mjohansson/customlib_mj/README.md

# customlib_mj
Kicad custom parts library by MJ
