mjohansson/customlib_mj/3d_models/DS3231_Module_MJ-assembly.stp

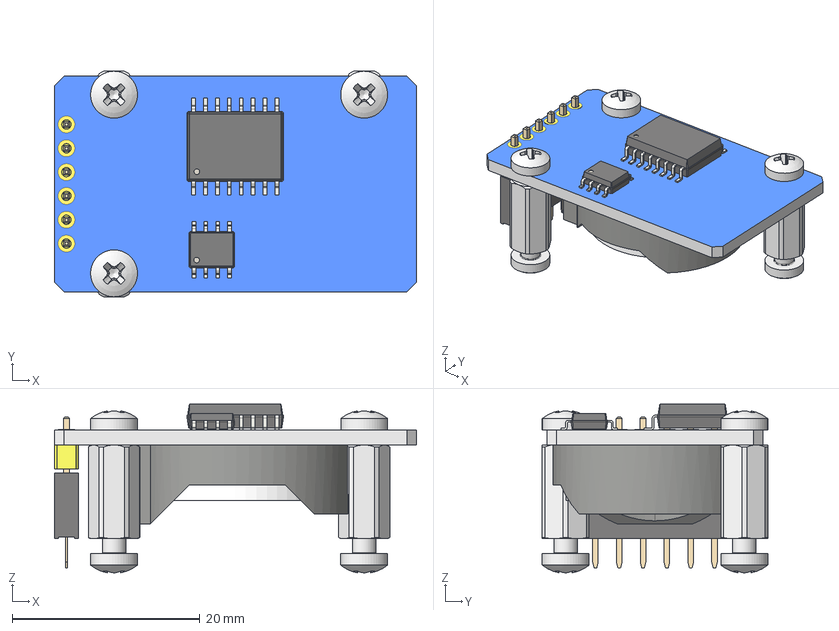
[picture p1: CAD file, 2021-01-10]
3d_models/DS3231_Module_MJ-assembly.stp
38.6 x 24.1 x 18.0 mm
DS3231_module_with_backup_battery
PinHeader_1x06_P254mm_Vertical
Battery_Holder
DS3231SN_SOIC_16W
24C32N_SOIC_8
M2.5x5x10-Spacer
M2.5x5x10-Spacer001
M2.5x5x10-Spacer002
M2.5x6-Screw
M2.5x6-Screw008
M2.5x6-Screw002
M2.5x6-Screw003
M2.5x6-Screw006
M2.5x6-Screw007
PinSocket_1x06_P254mm_Vertical
