mjohansson/customlib_mj/3d_models/SMA_bulkhead_jack_and_cable_assy.stp

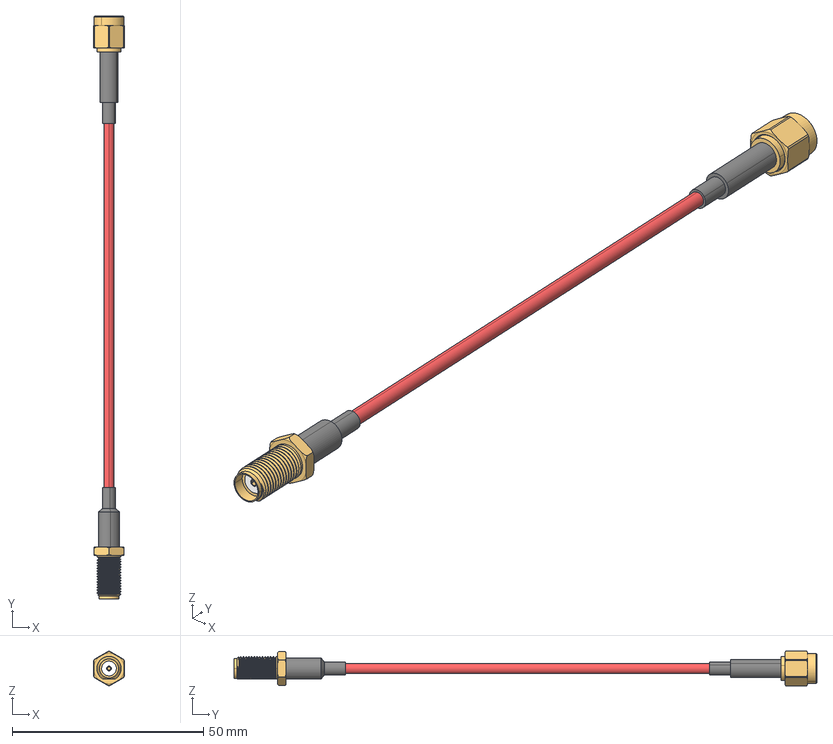
[picture p2: CAD file, 2021-01-10]
3d_models/SMA_bulkhead_jack_and_cable_assy.stp
8.00 x 152.4 x 9.04 mm
