mjohansson/customlib_mj/3d_models/3dholder_left_asm.stp

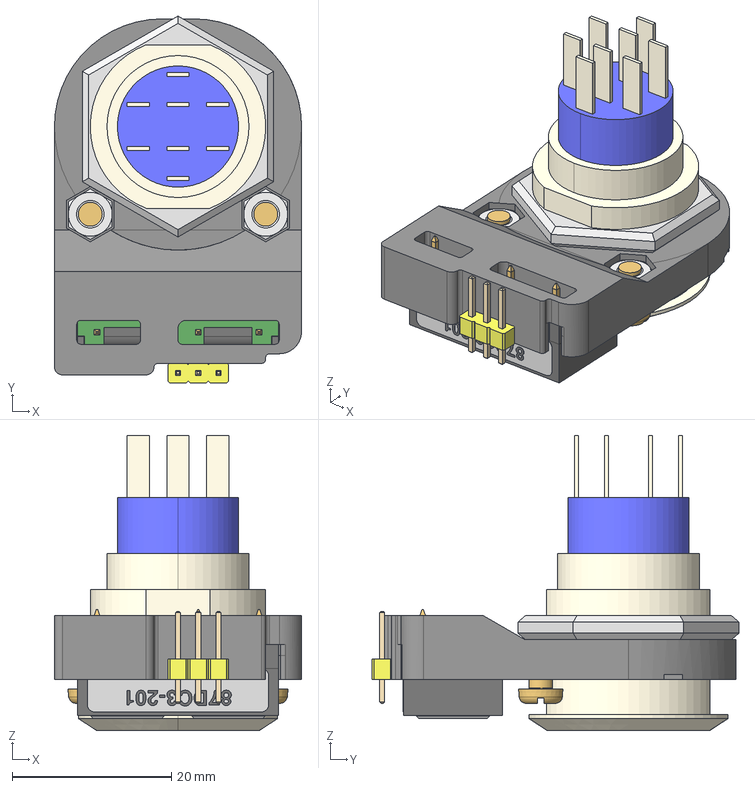
[picture p3: CAD file, 2021-01-10]
3d_models/3dholder_left_asm.stp
31.0 x 46.0 x 37.0 mm
PinHeader_1x03_P254mm_Vertical
RSpro_PowerButton_Blue
M3x6-Screw001
M3x6-Screw
3d_holder_left_v004
HexNut_M19_thin
M3-Nut
M3-Nut001
Compound_Grayhill_87DC3-201
