mjohansson/customlib_mj/3d_models/3dholder_right_asm.stp

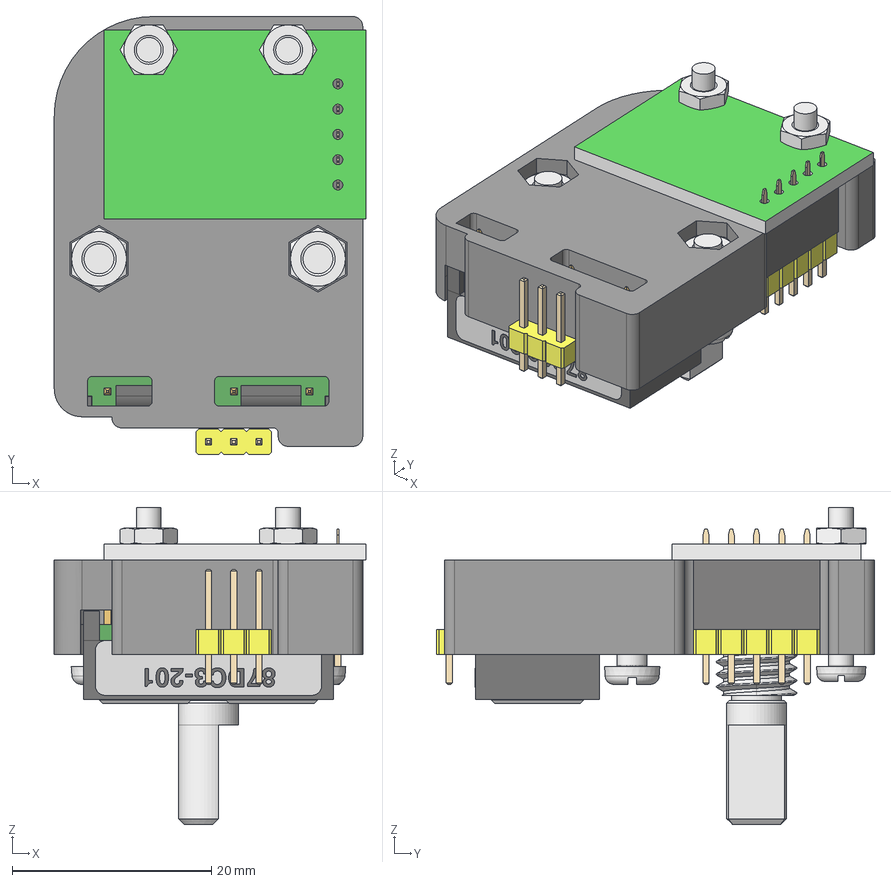
[picture p4: CAD file, 2021-01-10]
3d_models/3dholder_right_asm.stp
31.3 x 44.0 x 31.9 mm
PinSocket_1x05_P254mm_Vertical
PinHeader_1x05_P254mm_Vertical
PinHeader_1x03_P254mm_Vertical
3d_holder_right-r3
M2.5-Nut001
M2.5-Nut
M2.5x16-Screw001
M2.5x16-Screw
M3-Nut001
M3-Nut
M3x10-Screw001
M3x10-Screw
Compound_Grayhill_87DC3-201
Boolean
