mjohansson/customlib_mj/3d_models/Molex_PicoBlade_4p_Cable_assy-151340402.stp

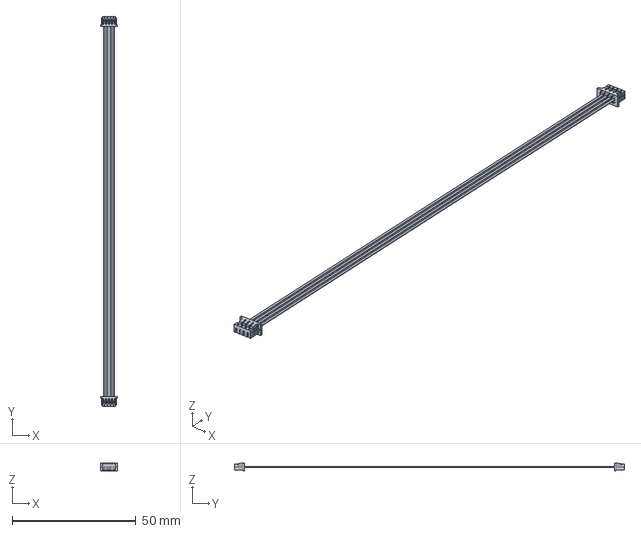
[picture p5: CAD file, 2020-11-03]
3d_models/Molex_PicoBlade_4p_Cable_assy-151340402.stp
6.75 x 157.9 x 3.20 mm
