mjohansson/customlib_mj/3d_models/Molex_PicoBlade_4p_Cable_assy-151340403.stp

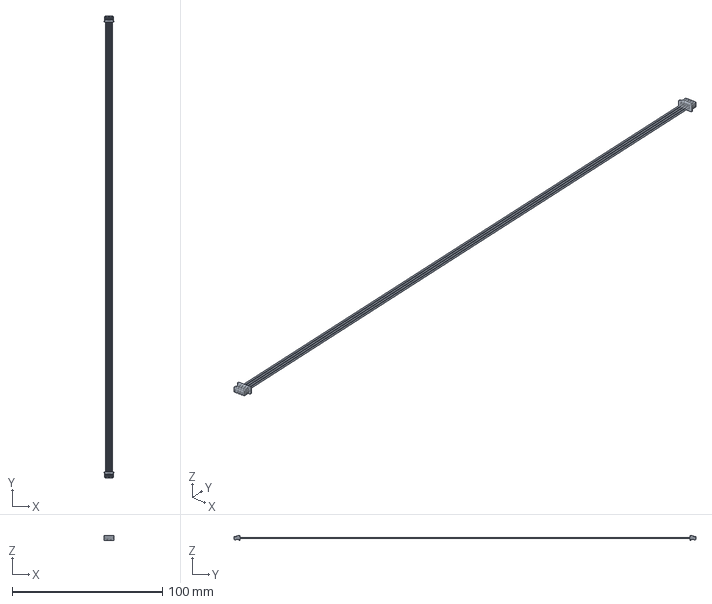
[picture p6: CAD file, 2020-11-03]
3d_models/Molex_PicoBlade_4p_Cable_assy-151340403.stp
6.75 x 307.9 x 3.20 mm
