mjohansson/customlib_mj/3d_models/CUI_DEVICES_CES-703116-28PM_fasteners_assembly.step

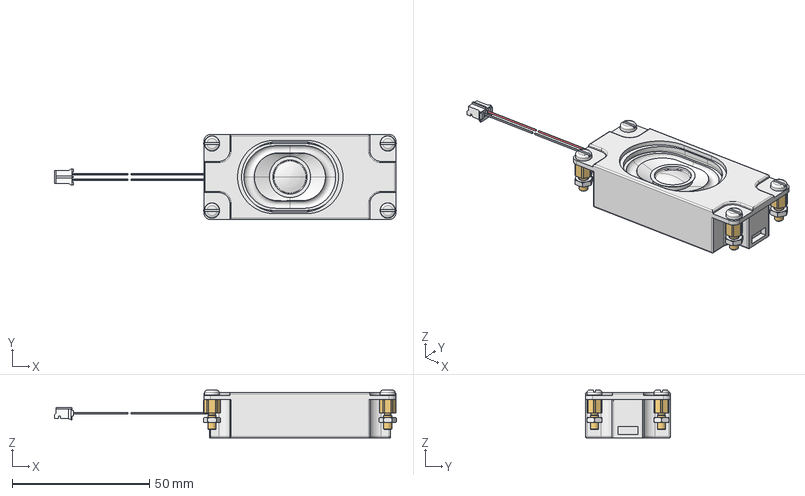
[picture p7: CAD file, 2020-09-05]
3d_models/CUI_DEVICES_CES-703116-28PM_fasteners_assembly.step
124.5 x 31.0 x 17.4 mm
CUI_DEVICES_CES-703116-28PM
M3x5.5x5-Standoff
M3x5.5x5-Standoff001
M3x5.5x5-Standoff002
M3x5.5x5-Standoff003
M3-Nut006 x 4
M3x5-Screw005 x 4
