mjohansson/customlib_mj/3d_models/Jing-Extension-of-the-Electronic-Co--920-E52A2021S10100_C10418.stp

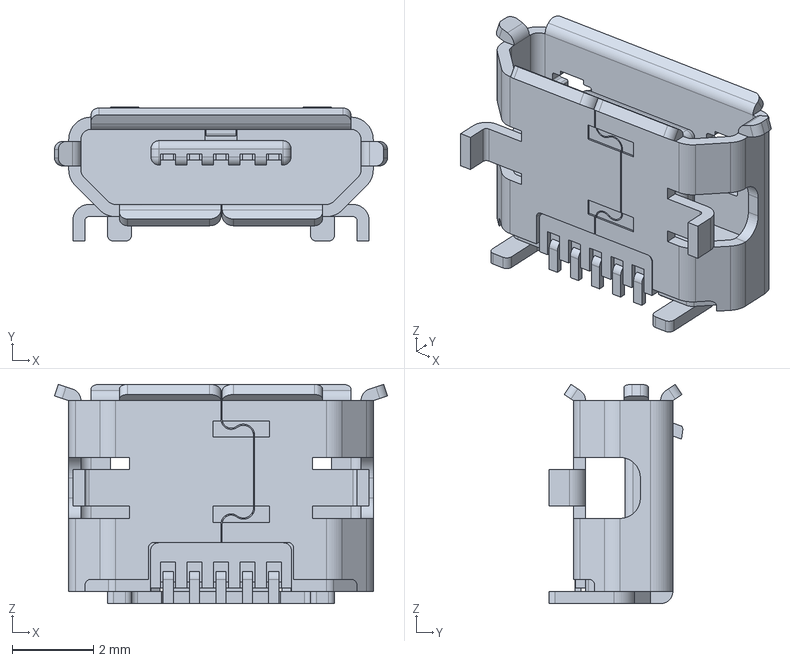
[picture p8: CAD file, 2024-02-26]
3d_models/Jing-Extension-of-the-Electronic-Co--920-E52A2021S10100_C10418.stp
8.20 x 3.30 x 5.40 mm
