mjohansson/customlib_mj/3d_models/3d_assm_bottomplate_w_feet.step

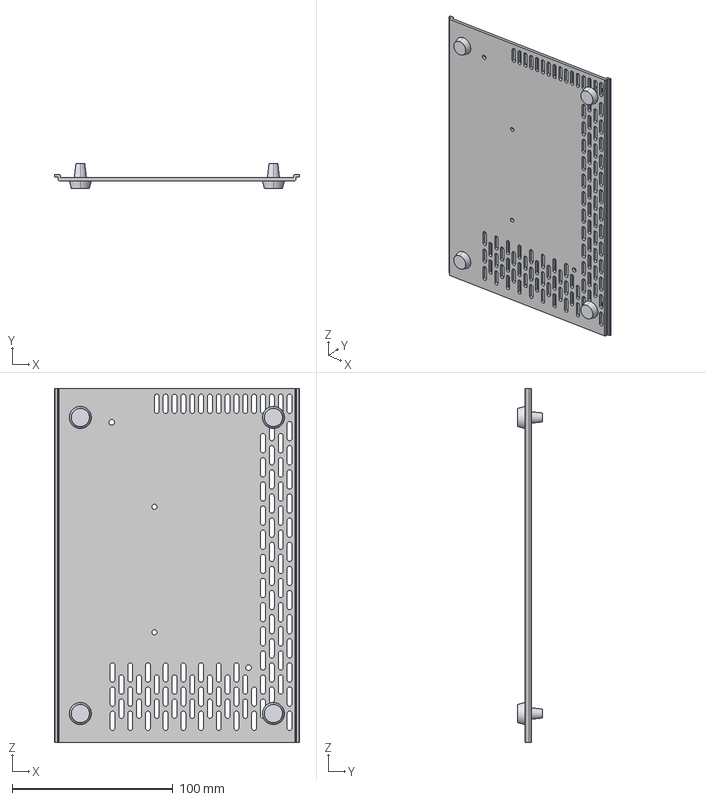
[picture p10: CAD file, 2022-02-02]
3d_models/3d_assm_bottomplate_w_feet.step
152.4 x 15.6 x 220.0 mm
Bottom_Cap_w_back_vent_slots001
POF-50185_push-on_feet-FL
POF-50185_push-on_feet-FR
POF-50185_push-on_feet-RR
POF-50185_push-on_feet-RL
