mjohansson/customlib_mj/3d_models/Distance9mm-Hex5mm_plus_M3x6.step

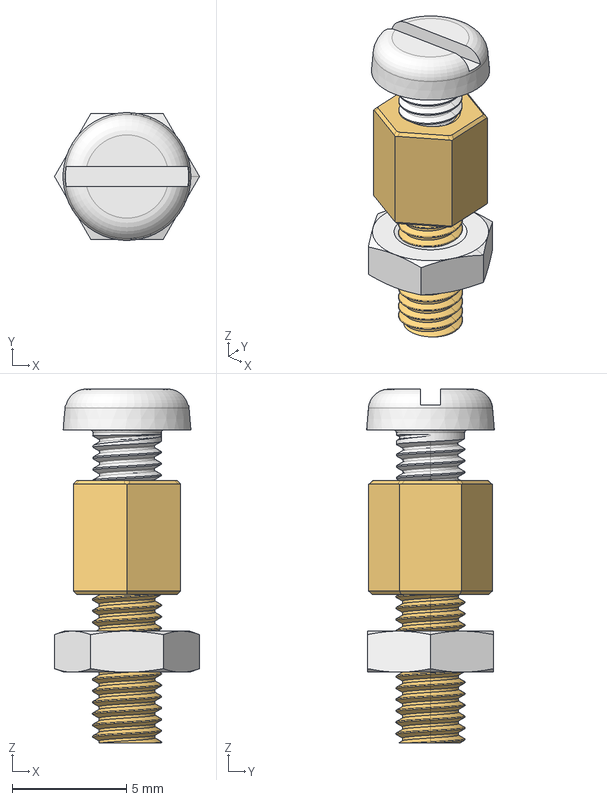
[picture p11: CAD file, 2021-01-10]
3d_models/Distance9mm-Hex5mm_plus_M3x6.step
6.35 x 5.60 x 15.5 mm
ISO1580-M3x6_screw
Hexdistance5mm_M3x6
ISO4035-M3_thin_nut
