mjohansson/customlib_mj/3d_models/FFC_14p_50mm_folded_x2.stp

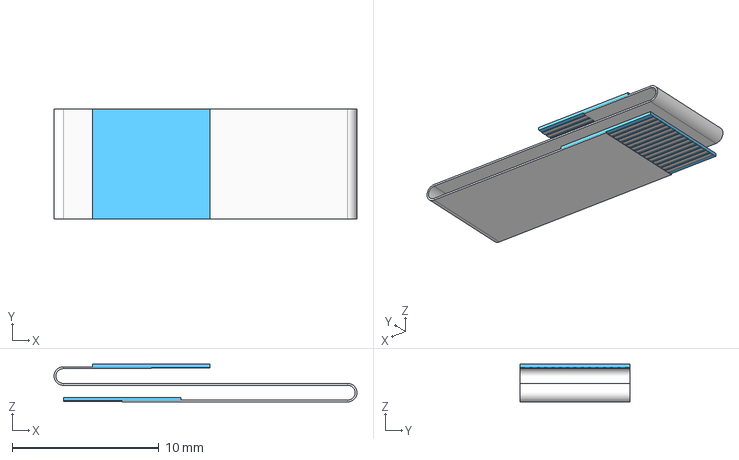
[picture p12: CAD file, 2021-01-10]
3d_models/FFC_14p_50mm_folded_x2.stp
20.6 x 7.50 x 2.57 mm
