mjohansson/customlib_mj/3d_models/SC74-6_SOT-457.stp

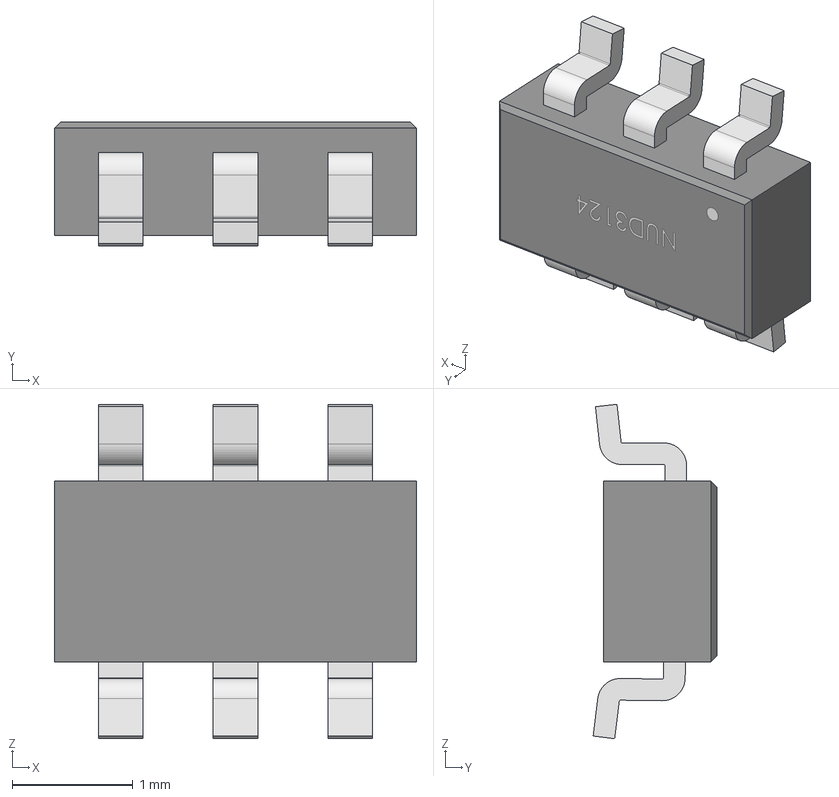
[picture p13: CAD file, 2021-01-10]
3d_models/SC74-6_SOT-457.stp
3.00 x 1.03 x 2.77 mm
