mjohansson/customlib_mj/3d_models/DistanceHex10mm_M3.step

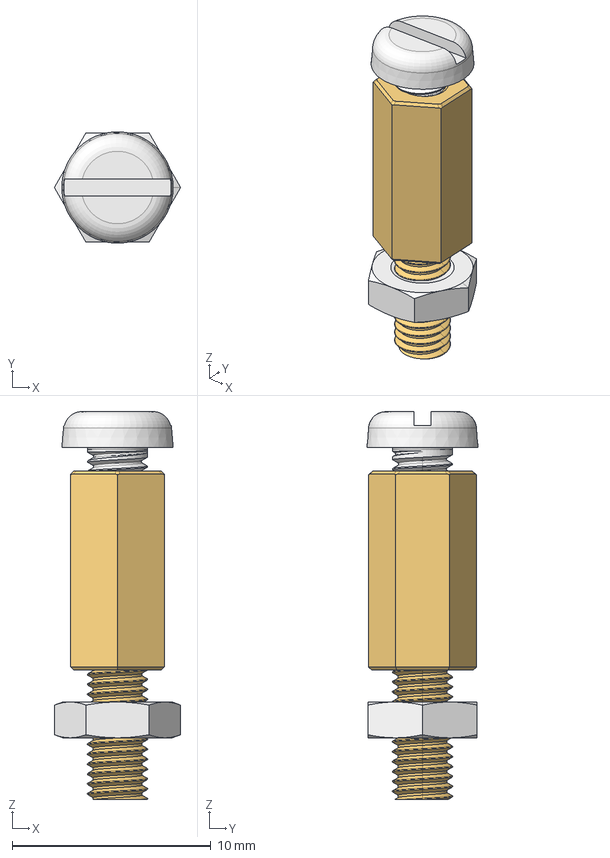
[picture p14: CAD file, 2021-01-10]
3d_models/DistanceHex10mm_M3.step
6.35 x 5.60 x 19.5 mm
Hexdistance10mm_M3
ISO4035-M3_NUT
ISO1580-M3x6_SCREW
