mjohansson/customlib_mj/3d_models/MJ_KY040_rotary.stp

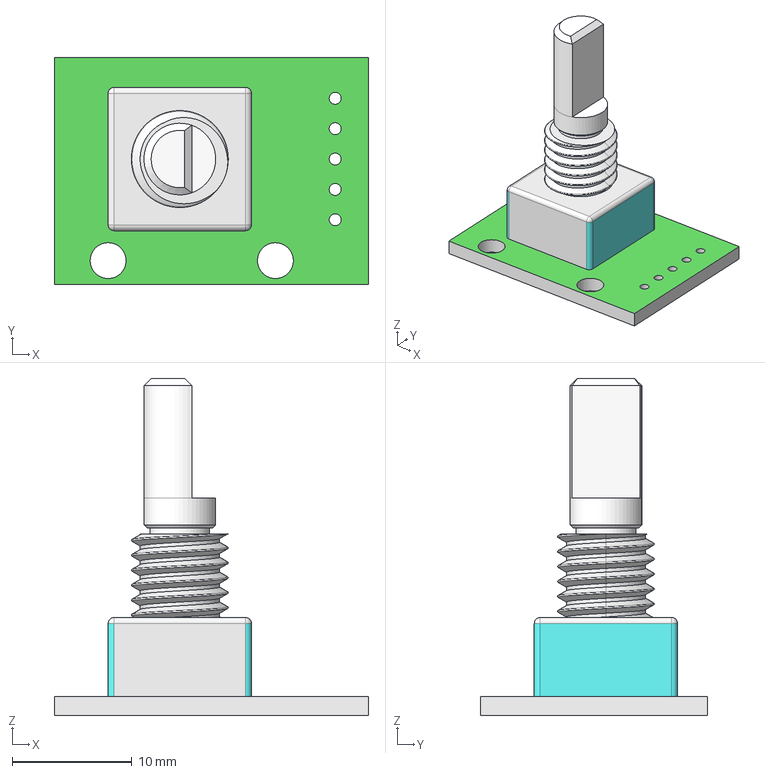
[picture p15: CAD file, 2021-01-10]
3d_models/MJ_KY040_rotary.stp
26.3 x 19.0 x 28.2 mm
M8x7.0-ScrewTap
