mjohansson/customlib_mj/3d_models/CoinCellHolder_CR2032.step

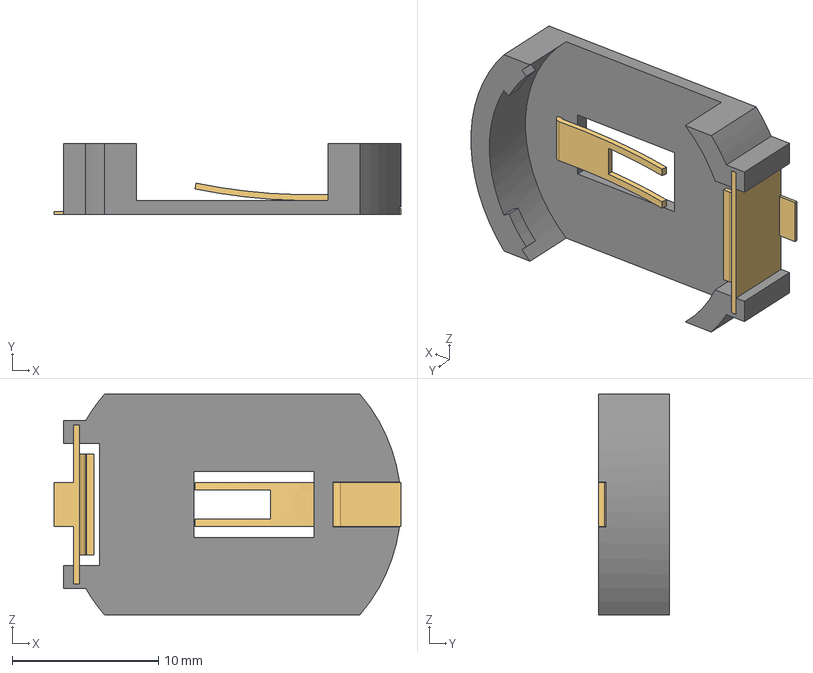
[picture p16: CAD file, 2021-01-10]
3d_models/CoinCellHolder_CR2032.step
23.8 x 4.86 x 15.1 mm
BLP2032M-Housing
BLP2032M-neg_terminal
BLP2032M-pos_terminal
