mjohansson/customlib_mj/3d_models/Mars_Schaffner.step

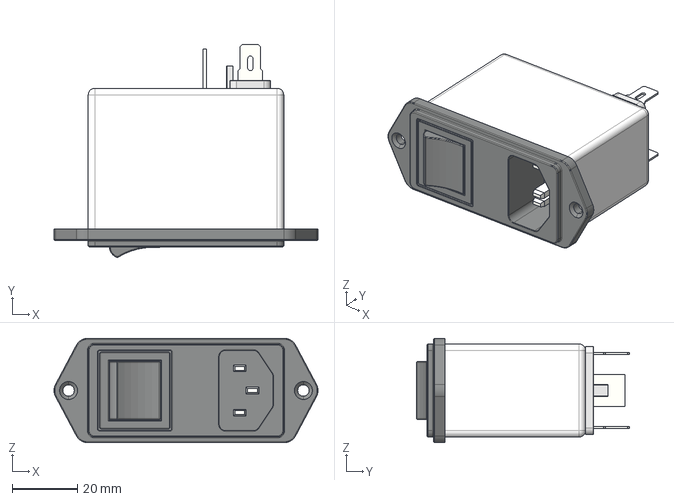
[picture p17: CAD file, 2021-01-10]
3d_models/Mars_Schaffner.step
80.9 x 65.3 x 32.0 mm
