mjohansson/customlib_mj/3d_models/Amphenol_C707_10M006_052_2.stp

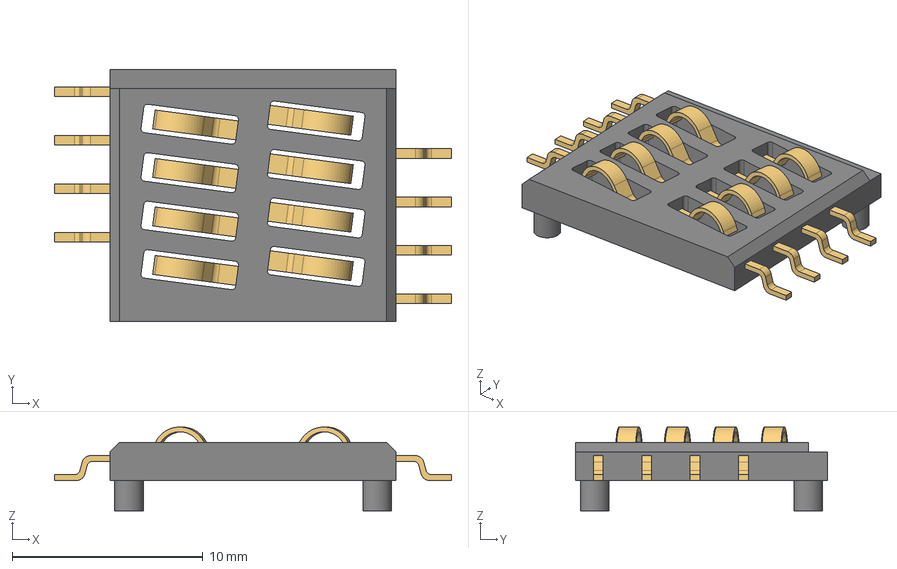
[picture p18: CAD file, 2021-01-10]
3d_models/Amphenol_C707_10M006_052_2.stp
20.8 x 13.2 x 4.40 mm
PlasticBlock_Body
Pin1
Pin2
Pin3
Pin4
Pin5
Pin6
Pin7
Pin8
SpringContact5
SpringContact6
SpringContact7
SpringContact8
SpringContact1
SpringContact2
SpringContact3
SpringContact4
