mjohansson/customlib_mj/3d_models/DIN7_done.stp

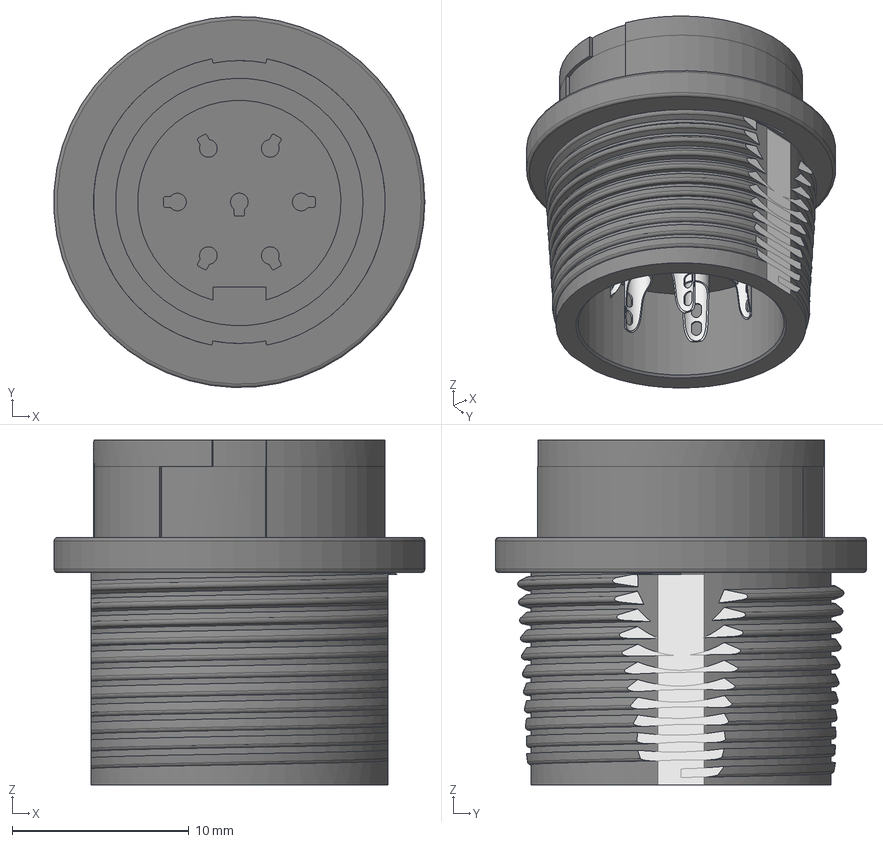
[picture p19: CAD file, 2021-01-10]
3d_models/DIN7_done.stp
21.0 x 21.0 x 19.5 mm
