mjohansson/customlib_mj/3d_models/87-DC3-201_simple.stp

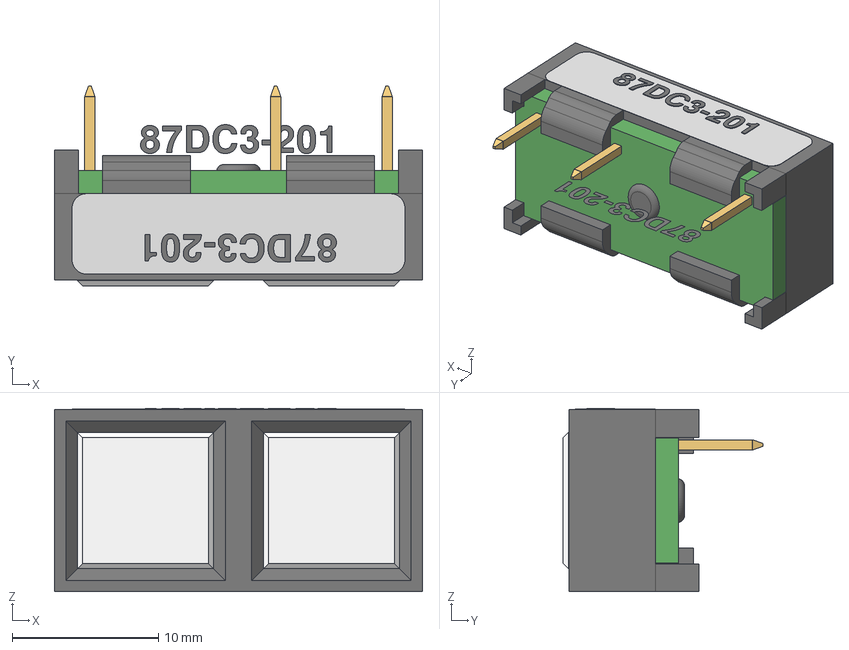
[picture p20: CAD file, 2021-01-10]
3d_models/87-DC3-201_simple.stp
25.1 x 13.6 x 12.5 mm
87DC3-201Body
ButtonLeftBody
ButtonRightBody
PCBBody
COMMON-Brass_pin-5.75mm
BTN_A-Brass_pin-5.75mm
BTN_B-Brass_pin-5.75mm
LabelBody
Sketch016
LabelTextShapeString
LabelTextExtrude
