mjohansson/customlib_mj/3d_models/Schurter_0031_8201.step

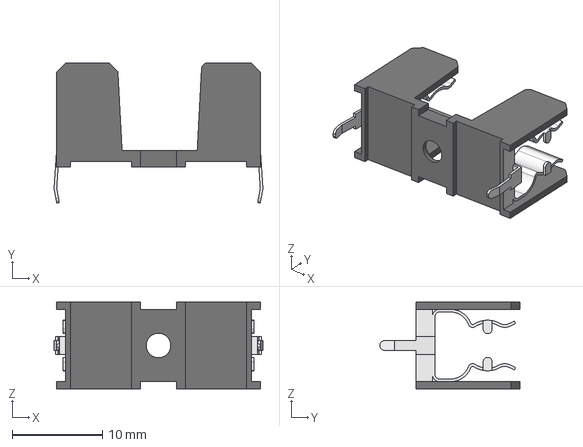
[picture p21: CAD file, 2021-01-10]
3d_models/Schurter_0031_8201.step
23.1 x 15.5 x 9.60 mm
