mjohansson/customlib_mj/3d_models/BATT_CR2032.step

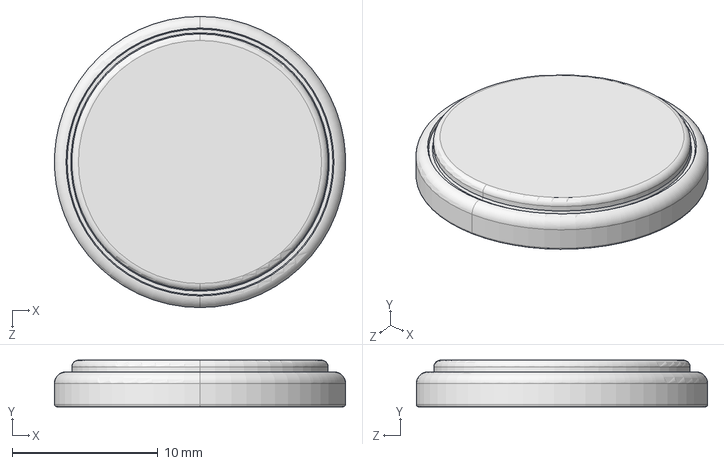
[picture p22: CAD file, 2021-01-10]
3d_models/BATT_CR2032.step
20.0 x 3.20 x 20.0 mm
