mjohansson/customlib_mj/3d_models/CUI_CES-30207-158L120-67.step

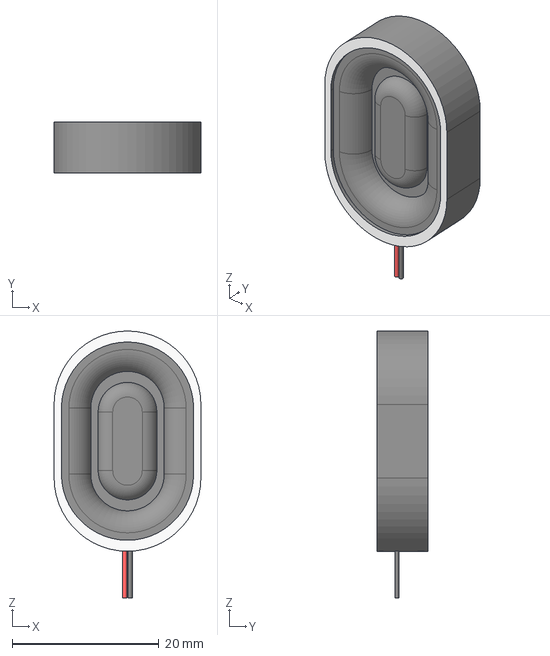
[picture p23: CAD file, 2021-01-10]
3d_models/CUI_CES-30207-158L120-67.step
20.0 x 7.00 x 36.4 mm
