mjohansson/customlib_mj/3d_models/FFC_14p-Molex_5052781433.stp

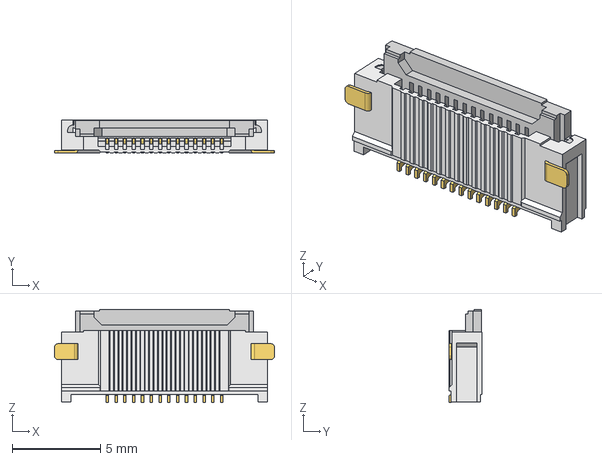
[picture p24: CAD file, 2021-01-10]
3d_models/FFC_14p-Molex_5052781433.stp
12.5 x 1.90 x 5.30 mm
