mjohansson/customlib_mj/3d_models/SOIC-16_3.9x9.9mm_P1.27mm.step

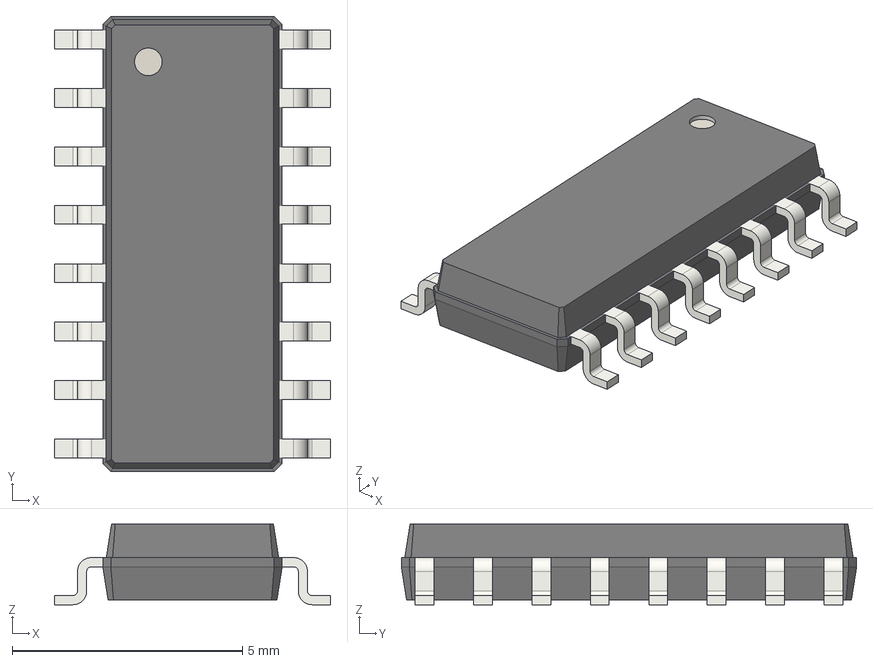
[picture p25: CAD file, 2021-01-09]
3d_models/SOIC-16_3.9x9.9mm_P1.27mm.step
6.00 x 9.90 x 1.75 mm
