mjohansson/customlib_mj/3d_models/Piezo-CUI_CSQ_601BP-Compatible_with_ZL-YDW12055.step

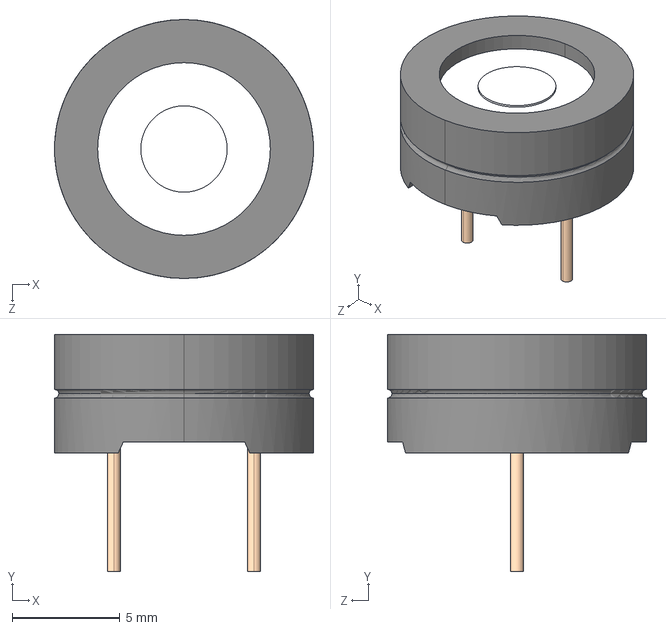
[picture p26: CAD file, 2021-01-09]
3d_models/Piezo-CUI_CSQ_601BP-Compatible_with_ZL-YDW12055.step
12.0 x 11.0 x 12.0 mm
