mjohansson/customlib_mj/3d_models/Oscillator_70x50mm_4p-matches_O705030MGDA4SC.step

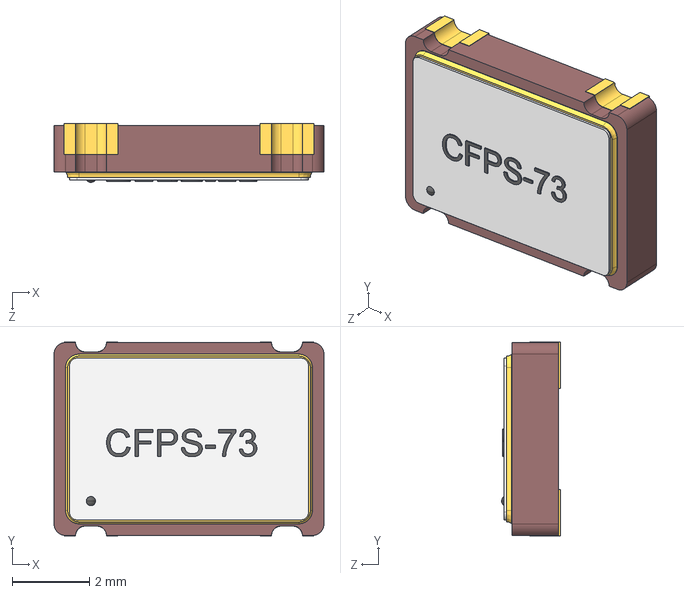
[picture p27: CAD file, 2021-01-09]
3d_models/Oscillator_70x50mm_4p-matches_O705030MGDA4SC.step
7.00 x 5.02 x 1.52 mm
