mjohansson/customlib_mj/3d_models/EC11E-15SW.STEP

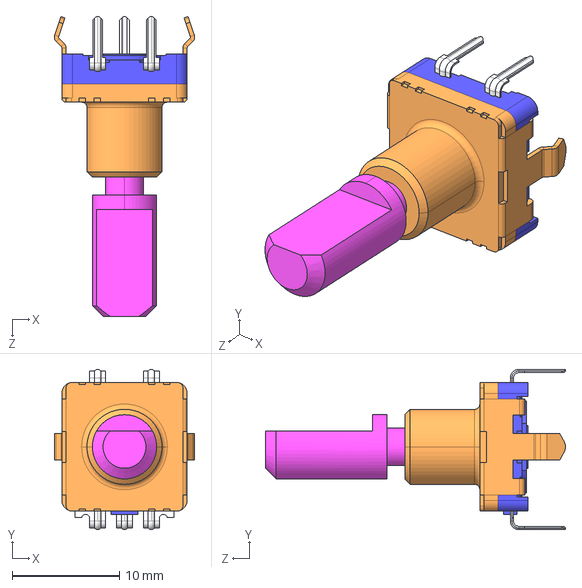
[picture p28: CAD file, 2021-01-09]
3d_models/EC11E-15SW.STEP
13.1 x 14.9 x 28.0 mm
