mjohansson/customlib_mj/3d_models/Piezo_CUI_CMT-13031-SMT-compatible_with_KLJ-1325.step

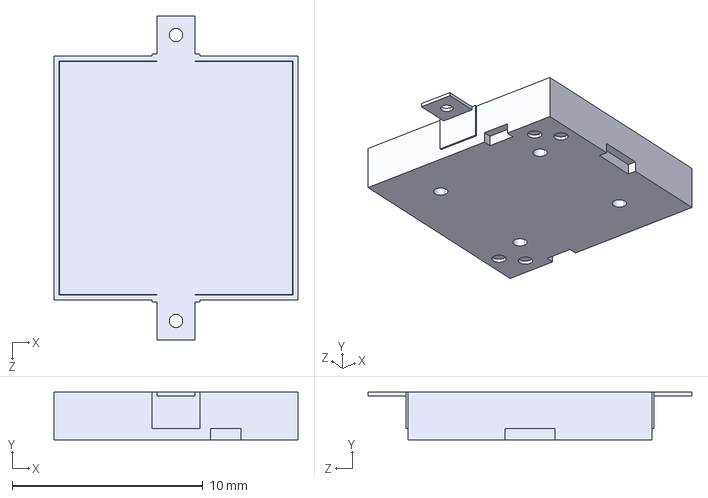
[picture p29: CAD file, 2021-01-09]
3d_models/Piezo_CUI_CMT-13031-SMT-compatible_with_KLJ-1325.step
12.8 x 2.50 x 17.0 mm
