mjohansson/customlib_mj/3d_models/cheap_chinese_micro_usb_port.step

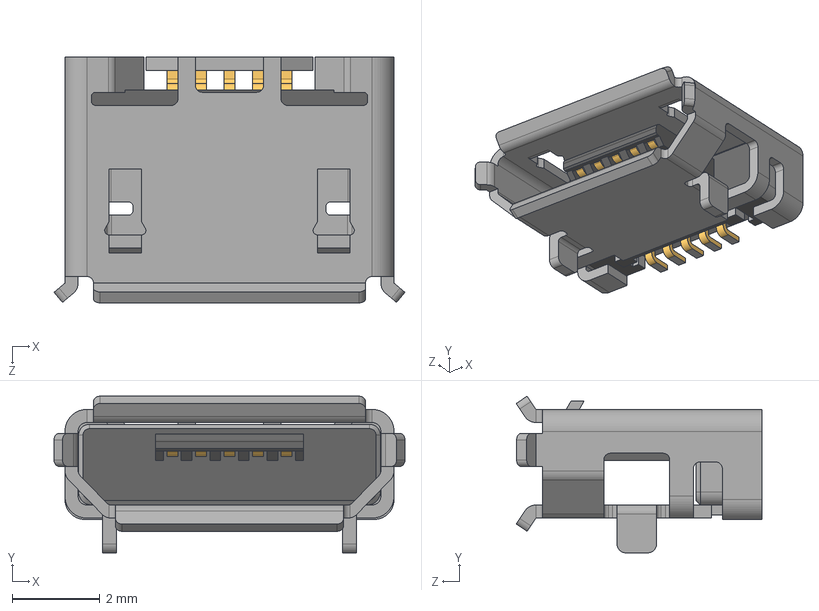
[picture p30: CAD file, 2021-01-09]
3d_models/cheap_chinese_micro_usb_port.step
8.00 x 3.57 x 5.60 mm
