mjohansson/customlib_mj/3d_models/SKQGAF.STEP

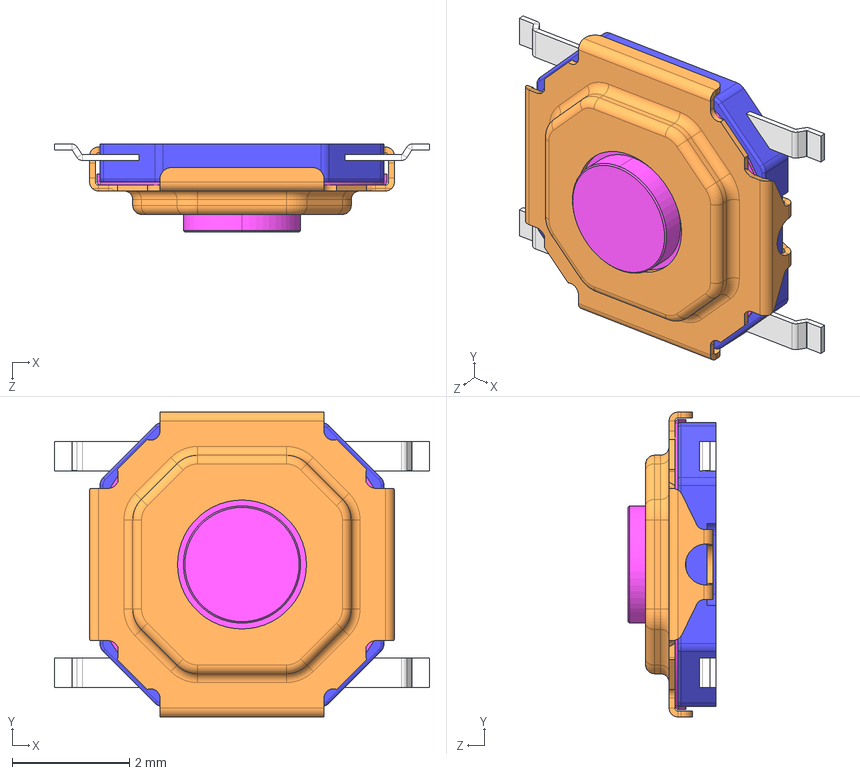
[picture p31: CAD file, 2021-01-09]
3d_models/SKQGAF.STEP
6.40 x 5.20 x 1.50 mm
