mjohansson/customlib_mj/3d_models/Litttlefuse 1206.step

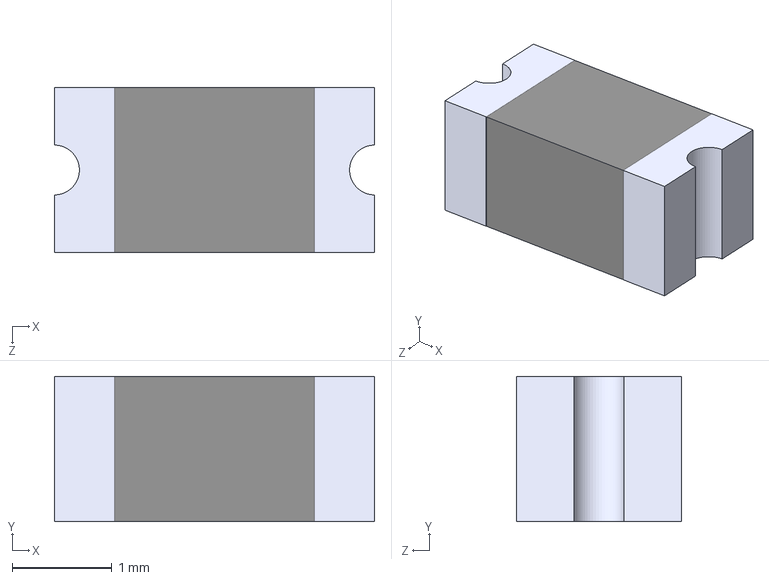
[picture p32: CAD file, 2021-01-09]
3d_models/Litttlefuse 1206.step
3.20 x 1.45 x 1.65 mm
