mjohansson/customlib_mj/3d_models/Schurter-0031.0060_002-fuseholder.stp

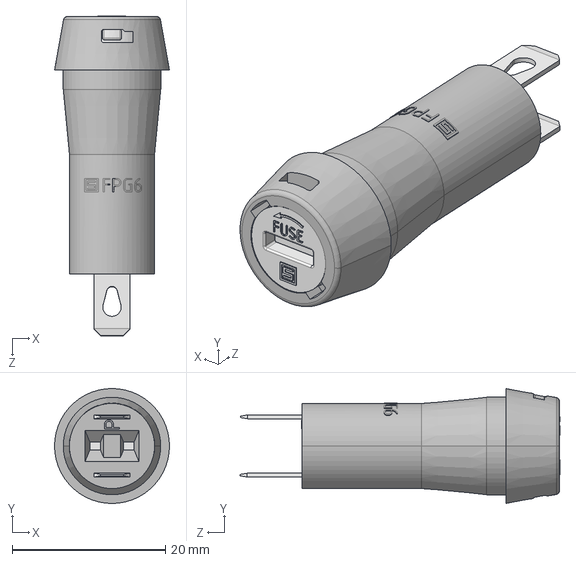
[picture p33: CAD file, 2021-01-09]
3d_models/Schurter-0031.0060_002-fuseholder.stp
15.0 x 15.0 x 41.7 mm
