mjohansson/customlib_mj/3d_models/HTSSOP-56-1EP_6.1x14mm_P0.5mm_EP3.61x6.35mm.step

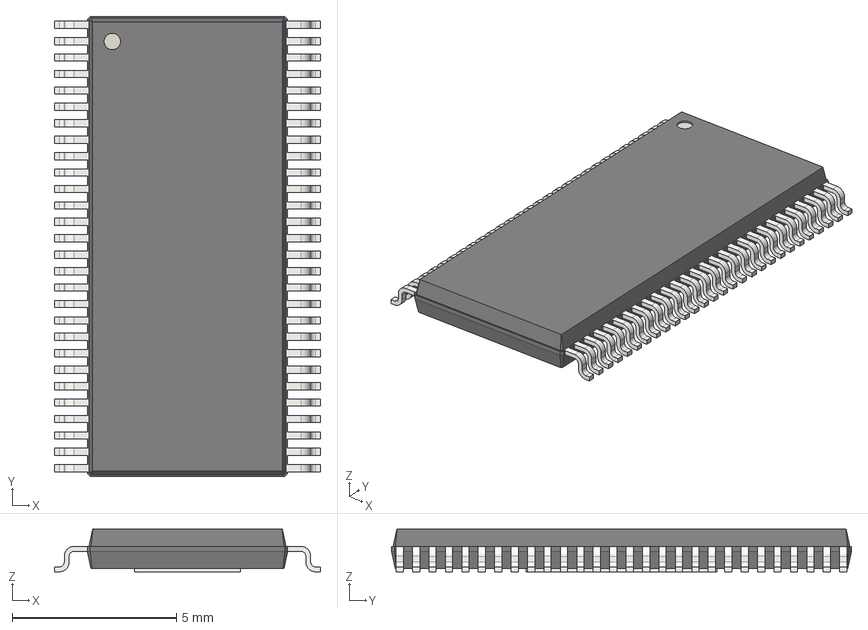
[picture p34: CAD file, 2021-01-09]
3d_models/HTSSOP-56-1EP_6.1x14mm_P0.5mm_EP3.61x6.35mm.step
8.10 x 14.0 x 1.30 mm
