mjohansson/customlib_mj/3d_models/Green_0603_sidelooking_LED.step

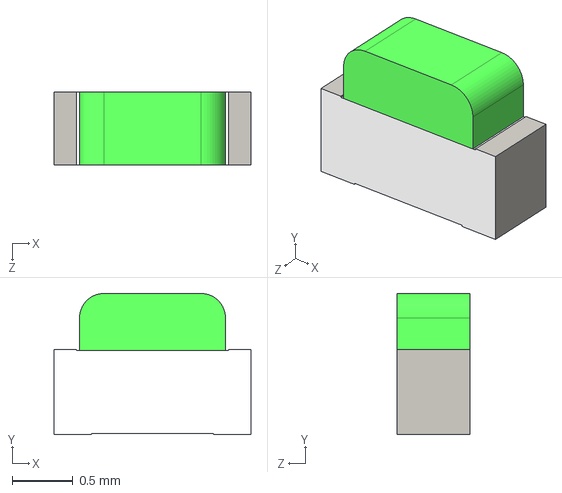
[picture p35: CAD file, 2021-01-09]
3d_models/Green_0603_sidelooking_LED.step
1.62 x 1.16 x 0.6 mm
