mjohansson/customlib_mj/3d_models/LED_RGB_3528RGB4C-CA.stp

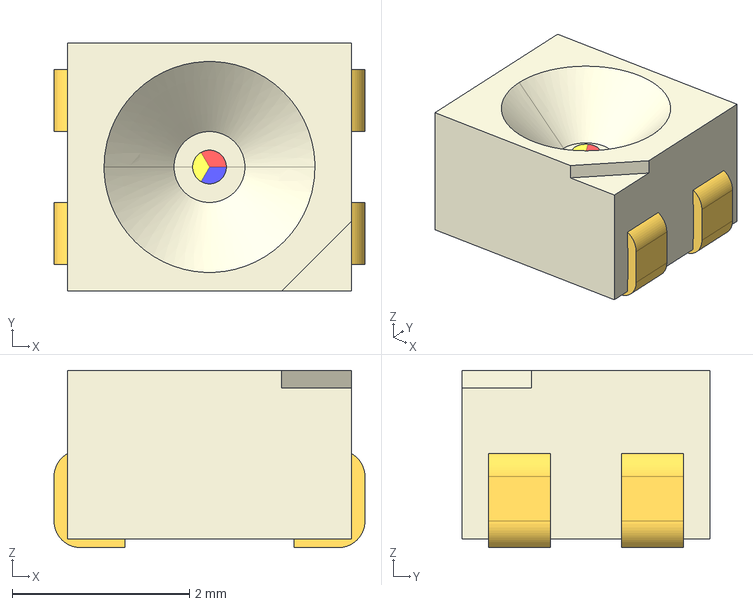
[picture p36: CAD file, 2020-12-30]
3d_models/LED_RGB_3528RGB4C-CA.stp
3.51 x 2.80 x 2.00 mm
