mjohansson/customlib_mj/3d_models/LED_RGB_SERIE_SK6812MINI.stp

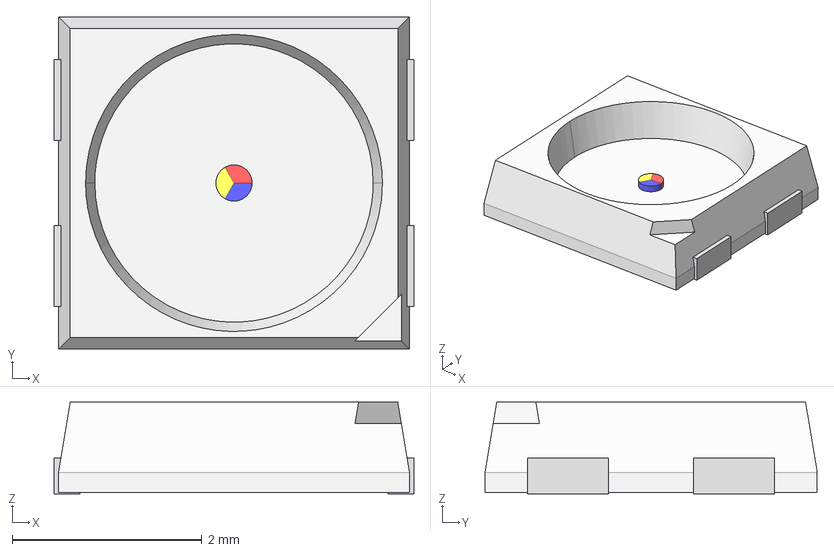
[picture p37: CAD file, 2020-12-30]
3d_models/LED_RGB_SERIE_SK6812MINI.stp
3.79 x 3.50 x 0.965 mm
