mjohansson/customlib_mj/3d_models/Molex_PicoBlade_4p_v_smd-533980471.stp

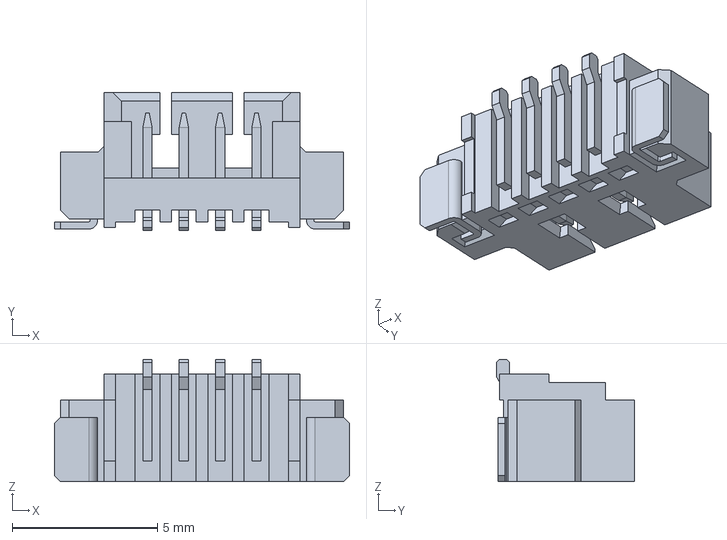
[picture p38: CAD file, 2020-11-09]
3d_models/Molex_PicoBlade_4p_v_smd-533980471.stp
10.2 x 4.75 x 4.20 mm
