mjohansson/customlib_mj/3d_models/WR-FAST_4ra_638263122004_rev1.stp

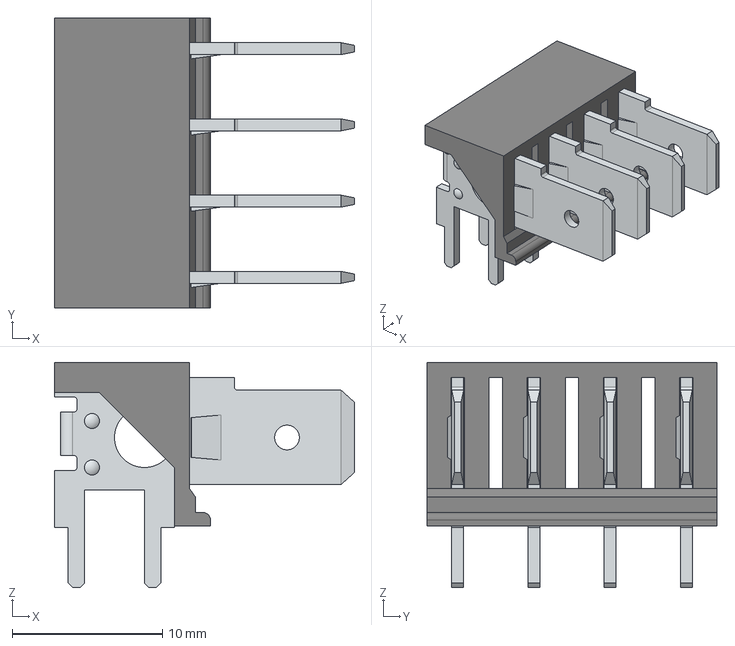
[picture p39: CAD file, 2020-11-03]
3d_models/WR-FAST_4ra_638263122004_rev1.stp
20.0 x 19.4 x 15.0 mm
