mjohansson/customlib_mj/3d_models/WR-FAST_3ra_638263122003_rev1.stp

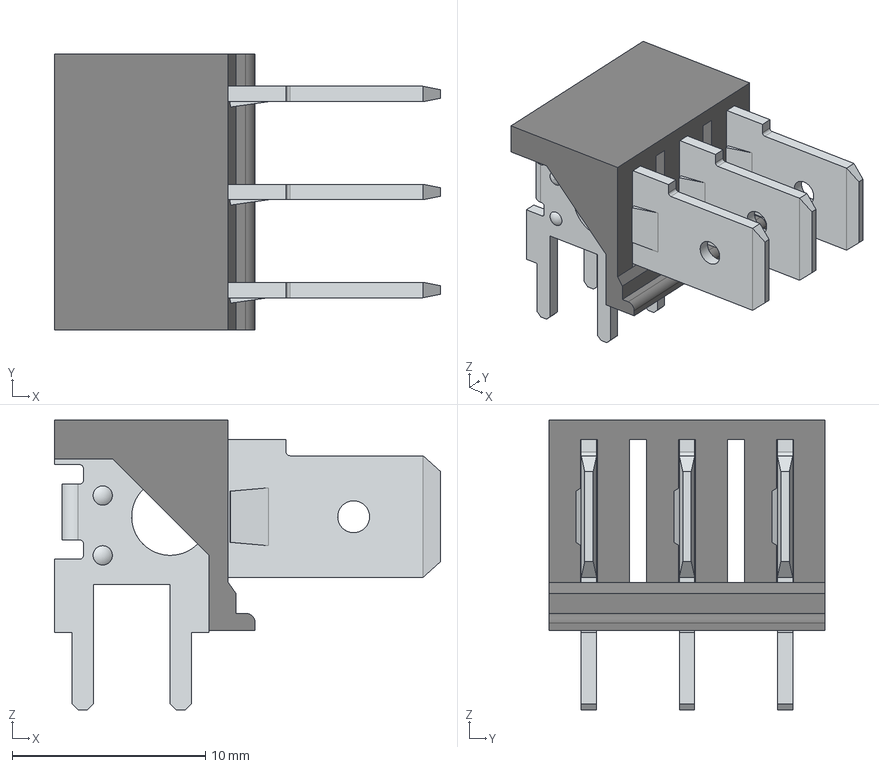
[picture p40: CAD file, 2020-11-03]
3d_models/WR-FAST_3ra_638263122003_rev1.stp
20.0 x 14.3 x 15.0 mm
