mjohansson/customlib_mj/3d_models/WR-FAST_2v_638263222002_rev1.stp

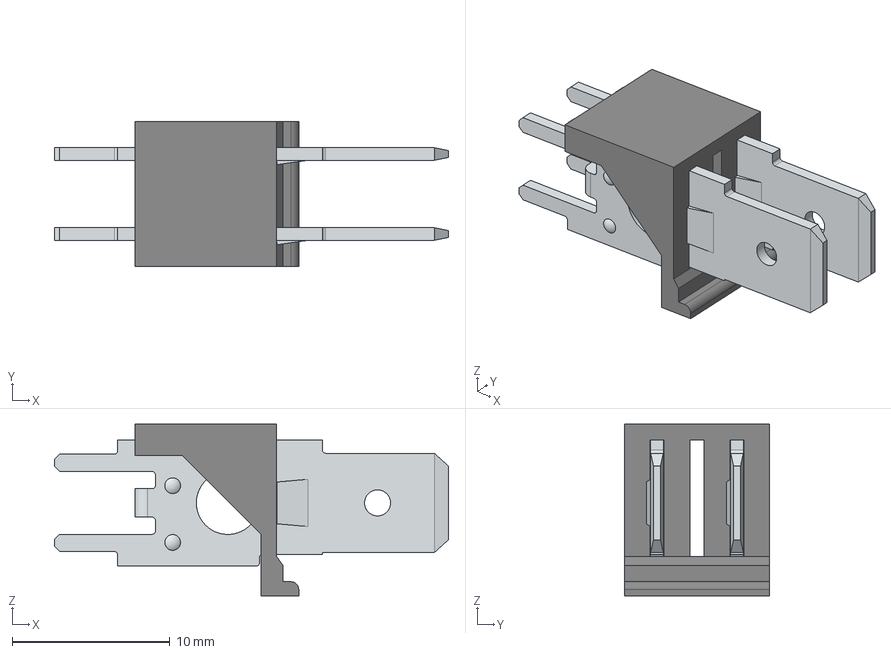
[picture p41: CAD file, 2020-11-03]
3d_models/WR-FAST_2v_638263222002_rev1.stp
25.0 x 9.20 x 10.9 mm
