mjohansson/customlib_mj/3d_models/WR-FAST_2ra_638263122002_rev1.stp

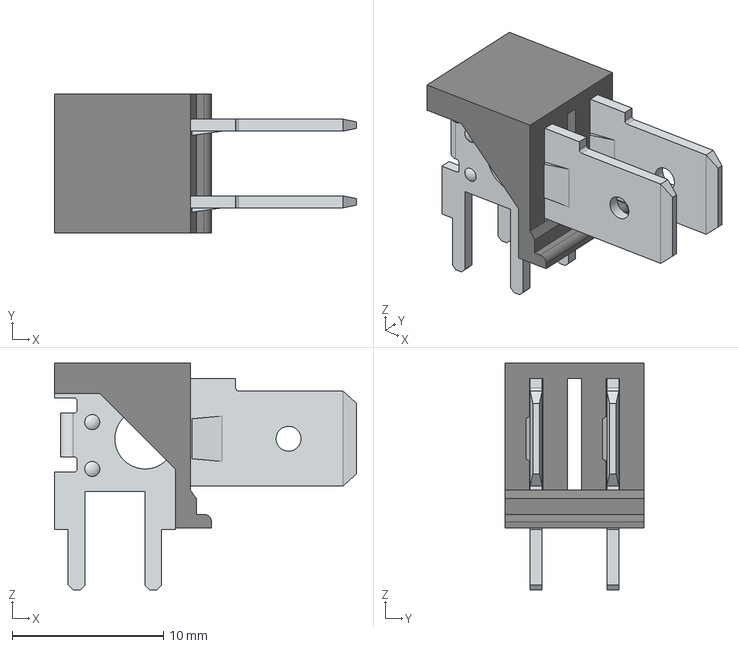
[picture p42: CAD file, 2020-11-03]
3d_models/WR-FAST_2ra_638263122002_rev1.stp
20.0 x 9.20 x 15.0 mm
