mjohansson/customlib_mj/3d_models/WR-FAST_4v_638263222004_rev1.stp

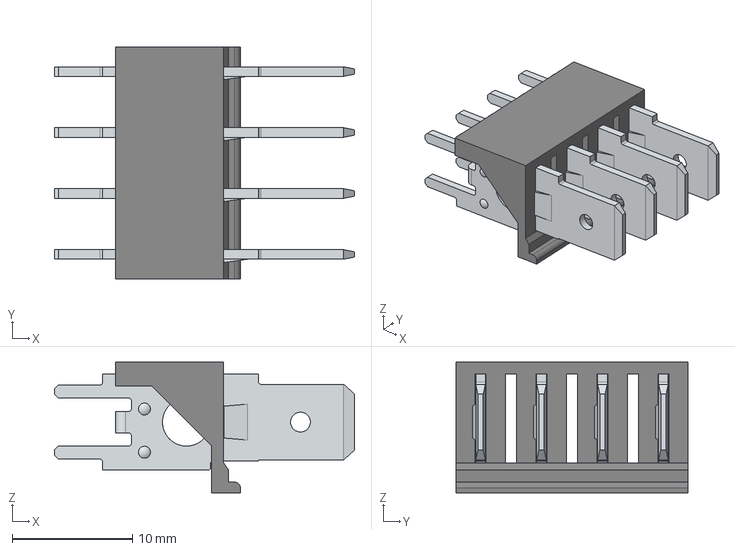
[picture p43: CAD file, 2020-11-03]
3d_models/WR-FAST_4v_638263222004_rev1.stp
25.0 x 19.4 x 10.9 mm
