mjohansson/customlib_mj/3d_models/WR-FAST_6v_638263222006_rev1.stp

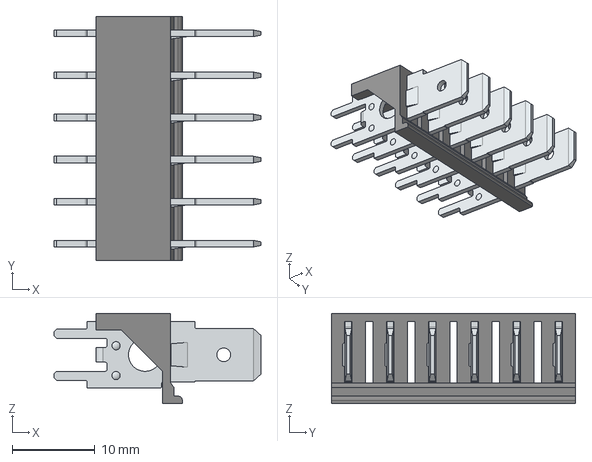
[picture p44: CAD file, 2020-11-03]
3d_models/WR-FAST_6v_638263222006_rev1.stp
25.0 x 29.5 x 10.9 mm
