mjohansson/customlib_mj/3d_models/WR-FAST_6ra_638263122006_rev1.stp

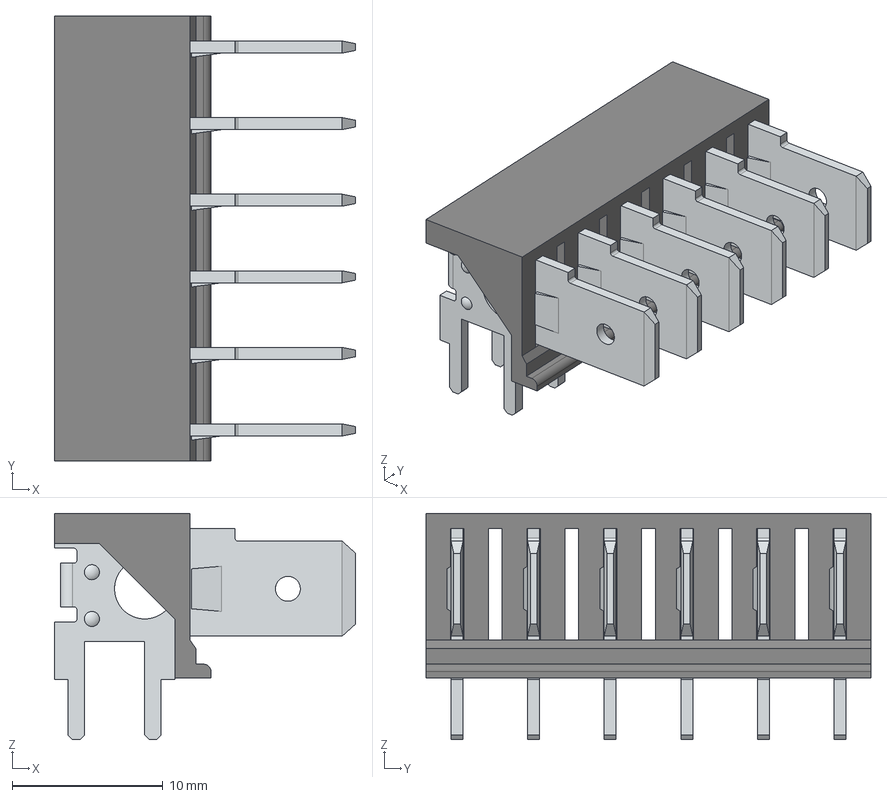
[picture p45: CAD file, 2020-11-03]
3d_models/WR-FAST_6ra_638263122006_rev1.stp
20.0 x 29.5 x 15.0 mm
