mjohansson/customlib_mj/3d_models/WR-FAST_3v_638263222003_rev1.stp

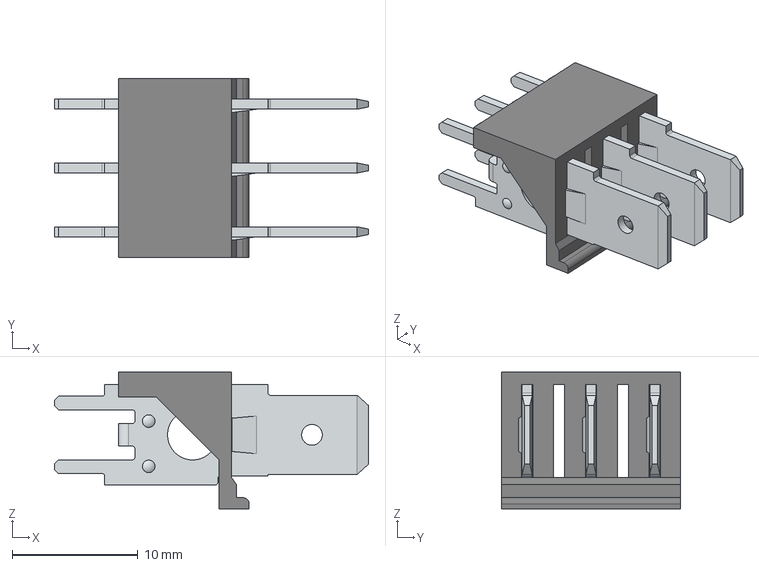
[picture p46: CAD file, 2020-11-03]
3d_models/WR-FAST_3v_638263222003_rev1.stp
25.0 x 14.3 x 10.9 mm
