mjohansson/customlib_mj/3d_models/Molex_MicroClasp_559350210.stp

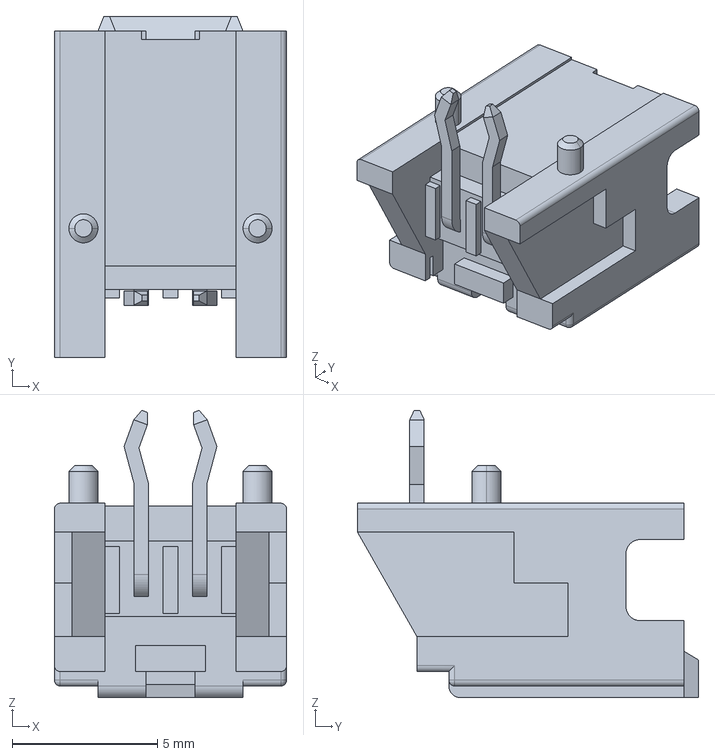
[picture p47: CAD file, 2020-10-24]
3d_models/Molex_MicroClasp_559350210.stp
8.00 x 11.8 x 9.90 mm
