mjohansson/customlib_mj/3d_models/JST-SM02(4.0)B-PBVSS-TB.STEP

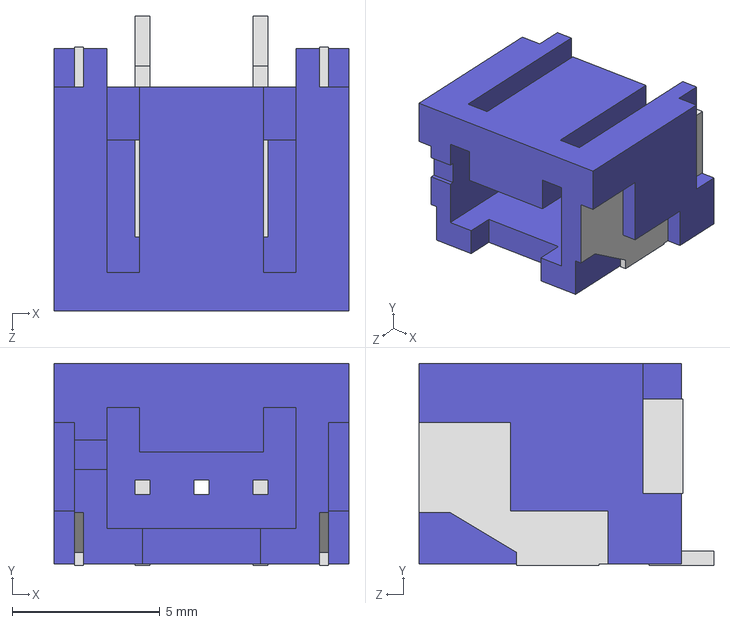
[picture p48: CAD file, 2020-10-24]
3d_models/JST-SM02(4.0)B-PBVSS-TB.STEP
10.0 x 6.85 x 10.0 mm
