mjohansson/customlib_mj/3d_models/JST-BM02(4.0)B-PBVSS-TF.STEP

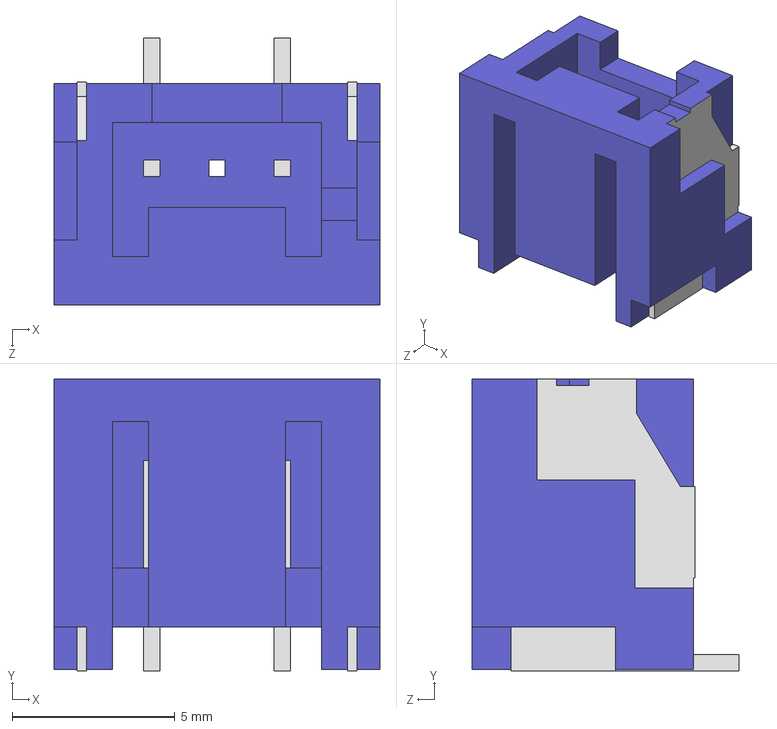
[picture p49: CAD file, 2020-10-24]
3d_models/JST-BM02(4.0)B-PBVSS-TF.STEP
10.0 x 8.95 x 8.20 mm
