mjohansson/customlib_mj/3d_models/JST_B2B-PH-SM4-TB.STEP

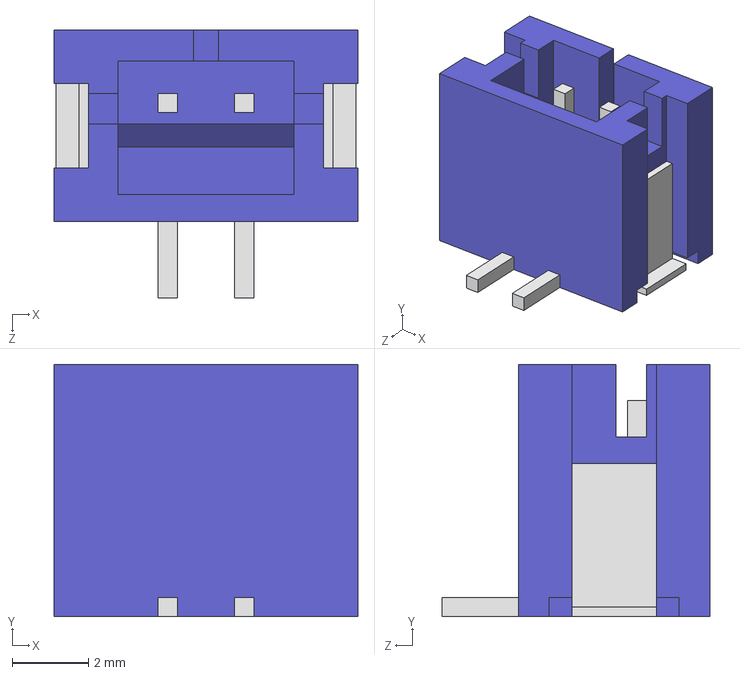
[picture p50: CAD file, 2020-10-24]
3d_models/JST_B2B-PH-SM4-TB.STEP
7.95 x 6.60 x 7.00 mm
