mjohansson/customlib_mj/3d_models/JST_S2B-PH-SM4-TB.STEP

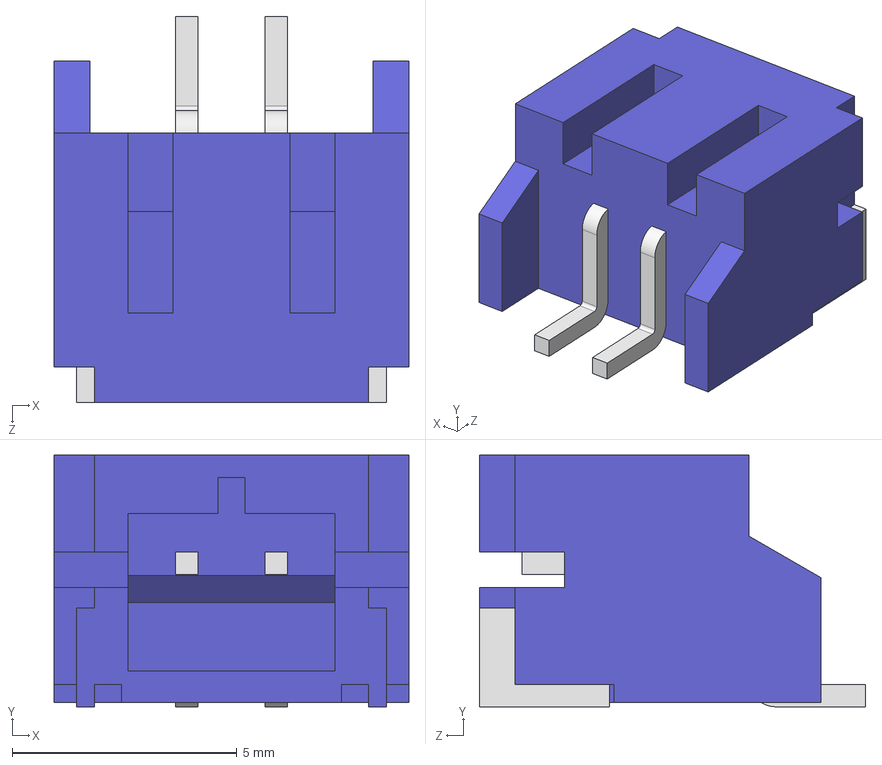
[picture p51: CAD file, 2020-10-24]
3d_models/JST_S2B-PH-SM4-TB.STEP
7.90 x 5.60 x 8.60 mm
