mjohansson/customlib_mj/3d_models/Molex_MicroFit_430450421.stp

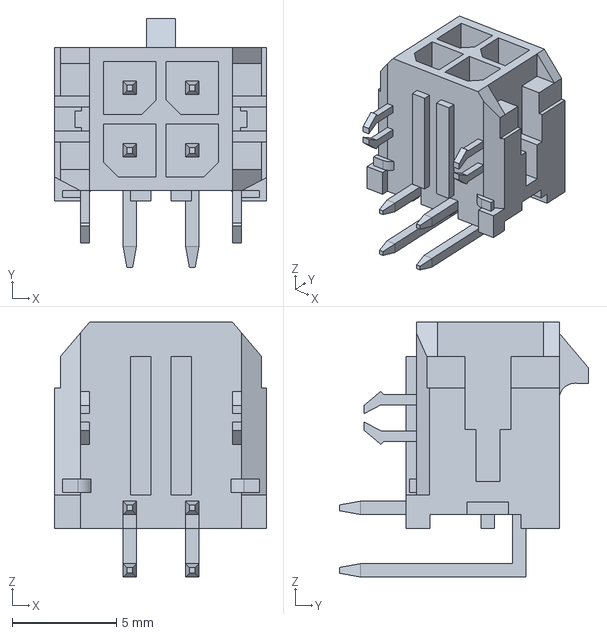
[picture p52: CAD file, 2020-10-20]
3d_models/Molex_MicroFit_430450421.stp
10.2 x 11.9 x 12.2 mm
