mjohansson/customlib_mj/3d_models/SMA_Molex_73251-2200_Horizontal.stp

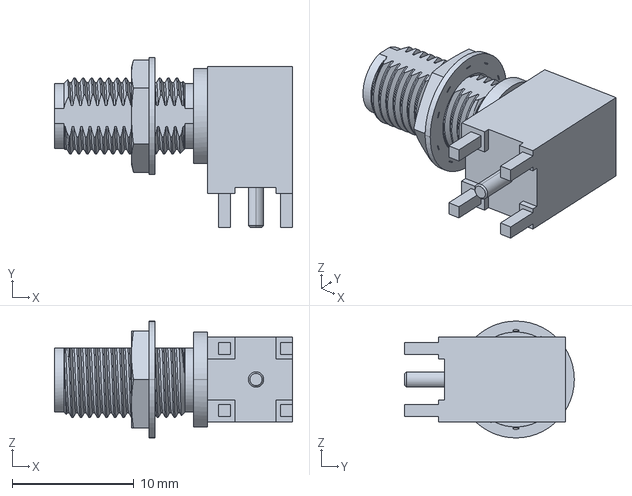
[picture p53: CAD file, 2020-10-07]
3d_models/SMA_Molex_73251-2200_Horizontal.stp
19.5 x 13.9 x 9.60 mm
