mjohansson/customlib_mj/3d_models/Molex_NanoFit_1x02-1054301202.stp

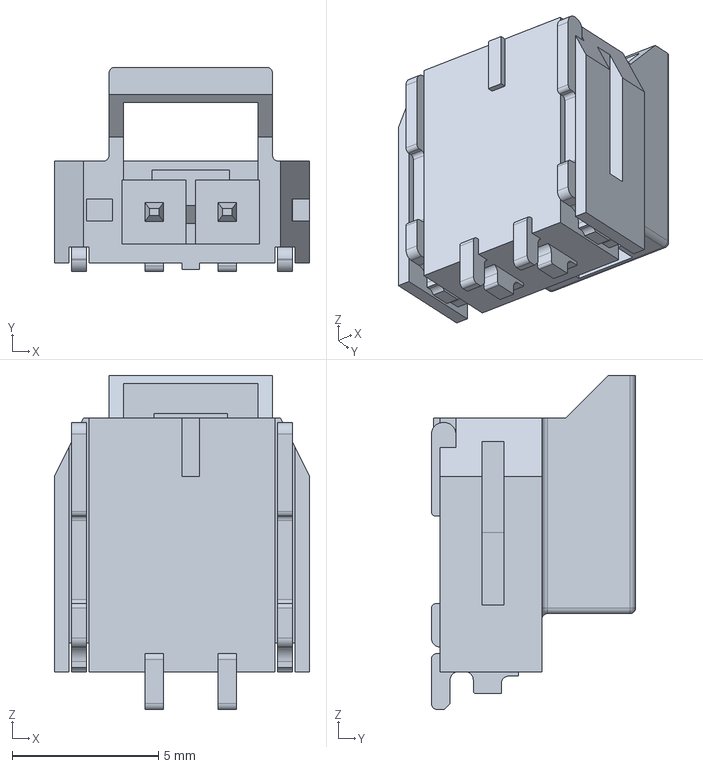
[picture p54: CAD file, 2020-10-07]
3d_models/Molex_NanoFit_1x02-1054301202.stp
8.74 x 6.99 x 11.4 mm
