mjohansson/customlib_mj/3d_models/Molex_NanoFit-1x02_receptacle-1053071202.stp

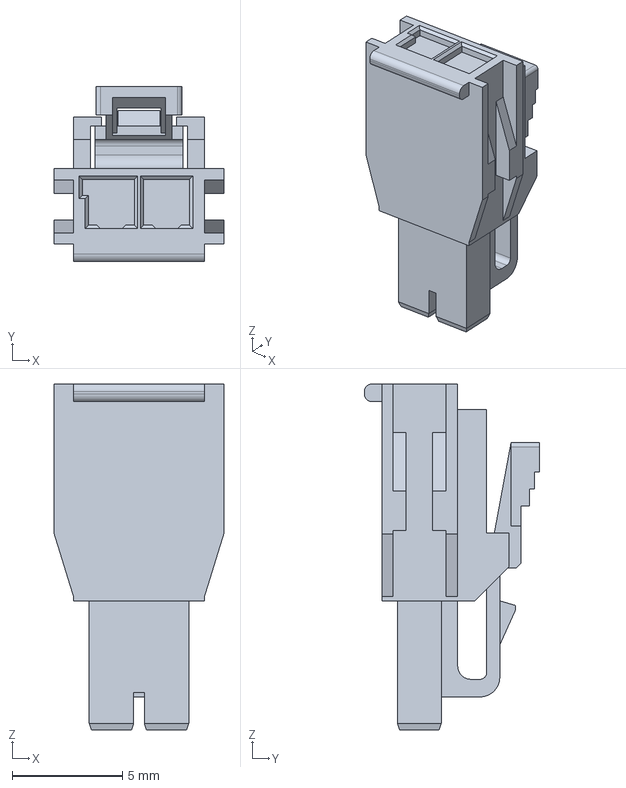
[picture p55: CAD file, 2020-10-07]
3d_models/Molex_NanoFit-1x02_receptacle-1053071202.stp
7.70 x 7.96 x 15.7 mm
