mjohansson/customlib_mj/3d_models/LB_I4R_A-red.stp

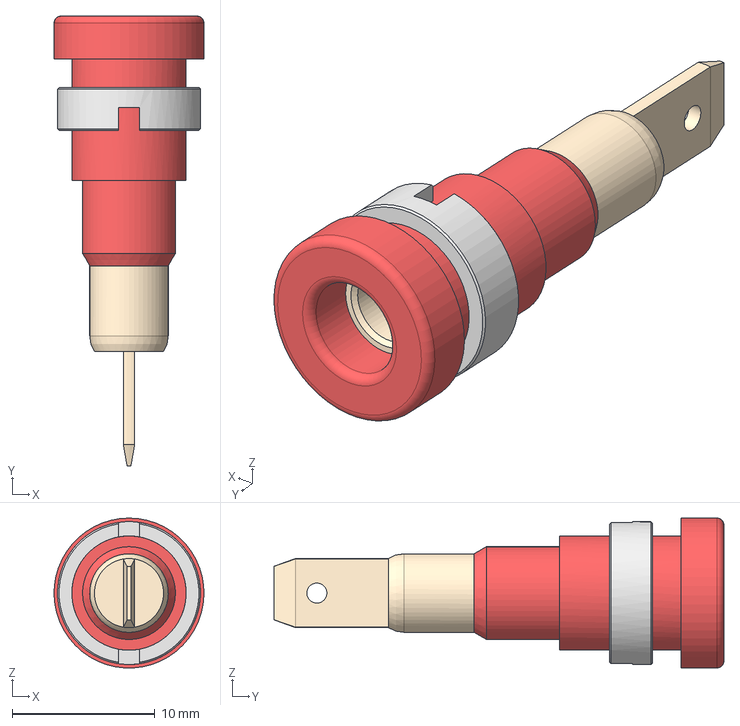
[picture p56: CAD file, 2020-10-06]
3d_models/LB_I4R_A-red.stp
10.5 x 31.5 x 10.5 mm
