mjohansson/customlib_mj/3d_models/LB_I4R_A-black.stp

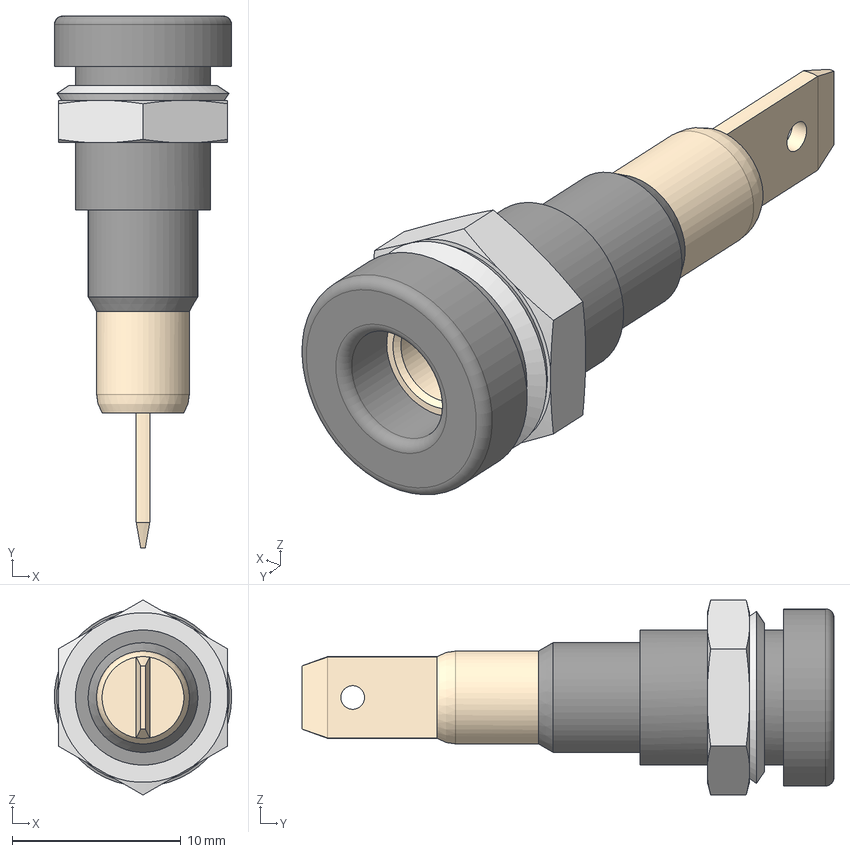
[picture p57: CAD file, 2020-10-06]
3d_models/LB_I4R_A-black.stp
10.5 x 31.5 x 11.5 mm
