mjohansson/customlib_mj/3d_models/CUI_DEVICES_UJ2-AH-1-SMT.step

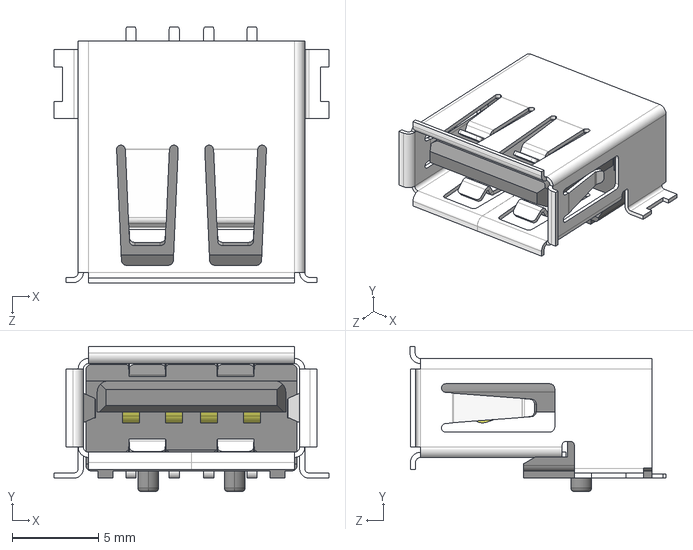
[picture p58: CAD file, 2020-10-06]
3d_models/CUI_DEVICES_UJ2-AH-1-SMT.step
15.9 x 8.40 x 14.8 mm
