mjohansson/customlib_mj/3d_models/CUI_DEVICES_CES-703116-28PM.step

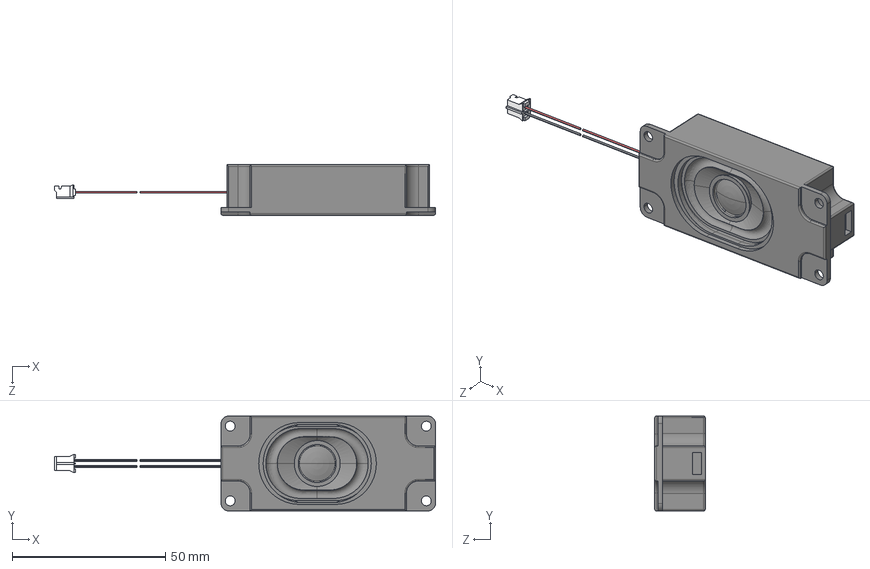
[picture p59: CAD file, 2020-09-05]
3d_models/CUI_DEVICES_CES-703116-28PM.step
124.3 x 31.0 x 16.5 mm
