mjohansson/customlib_mj/3d_models/K22X-E9P-N.step

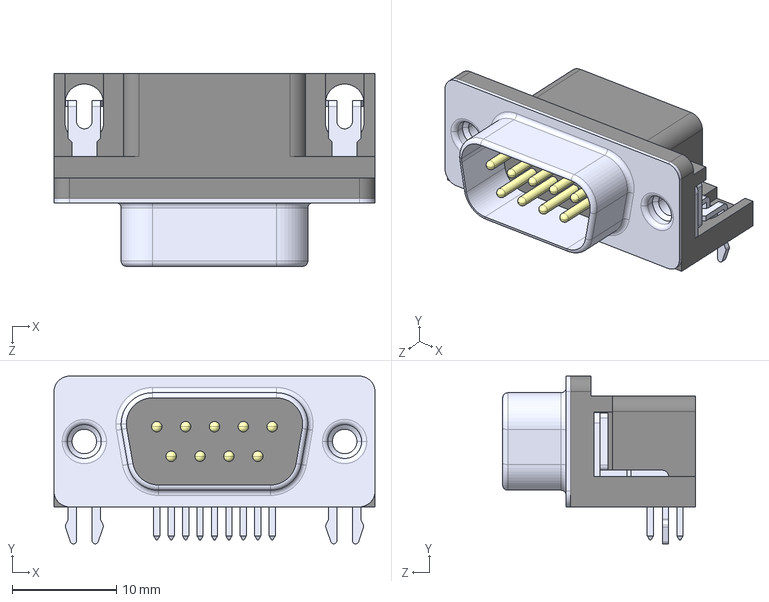
[picture p60: CAD file, 2020-09-03]
3d_models/K22X-E9P-N.step
30.8 x 16.1 x 18.5 mm
