mjohansson/customlib_mj/3d_models/AlKnob28mm-Mentor_5555_6612.stp

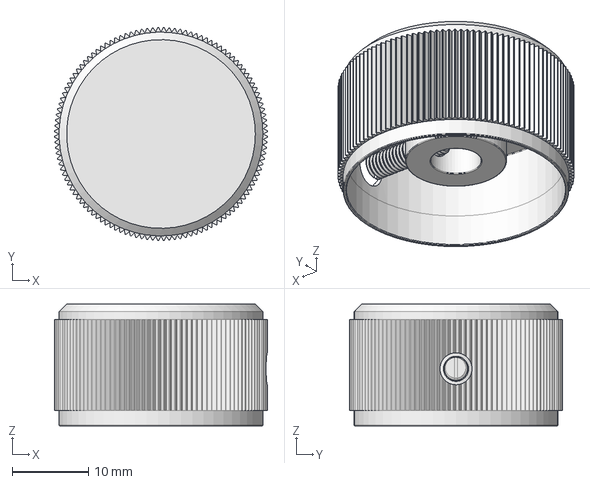
[picture p61: CAD file, 2020-08-24]
3d_models/AlKnob28mm-Mentor_5555_6612.stp
28.0 x 28.0 x 16.0 mm
KnobBody
LockScrewM3x10
