mjohansson/customlib_mj/3d_models/Grayhill_with_headers_2.FCStd

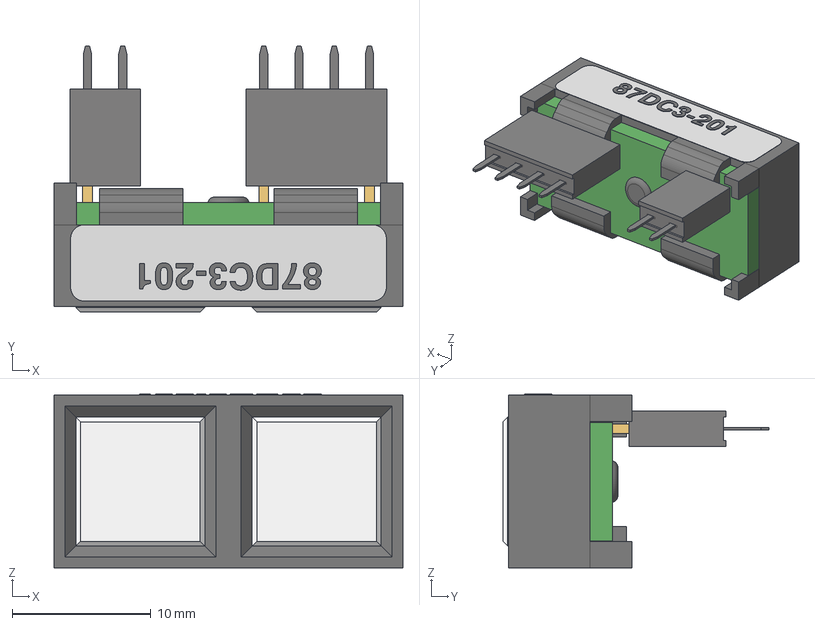
[picture p62: CAD file, 2020-08-18]
3d_models/Grayhill_with_headers_2.FCStd
25.1 x 19.2 x 12.5 mm
87DC3-201Body
ButtonLeftBody
ButtonRightBody
PCBBody
COMMON-Brass_pin-5.75mm
BTN_A-Brass_pin-5.75mm
BTN_B-Brass_pin-5.75mm
LabelBody
LabelTextExtrude
PinSocket_1x04_P254mm_Vertical
PinSocket_1x02_P254mm_Vertical
