mjohansson/customlib_mj/3d_models/CUI_DEVICES_SJ-3571N.step

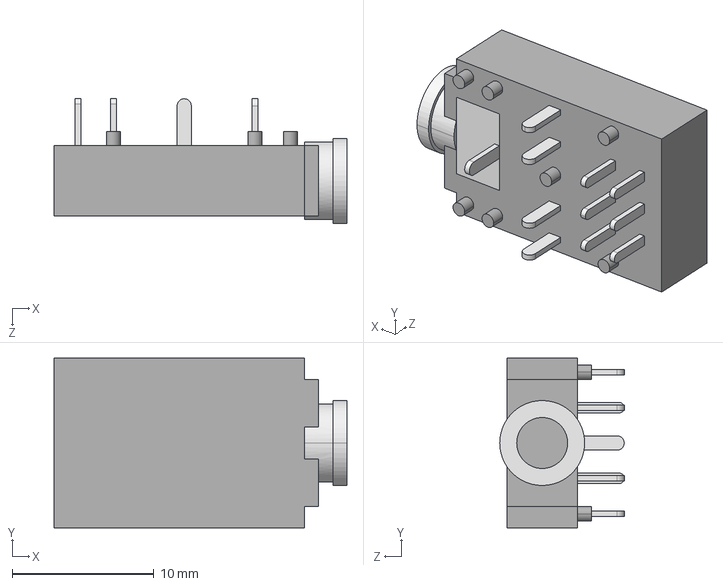
[picture p63: CAD file, 2020-08-18]
3d_models/CUI_DEVICES_SJ-3571N.step
20.7 x 12.0 x 8.80 mm
