mjohansson/customlib_mj/3d_models/Distance8mm-Hex5mm_plus_M3x5.step

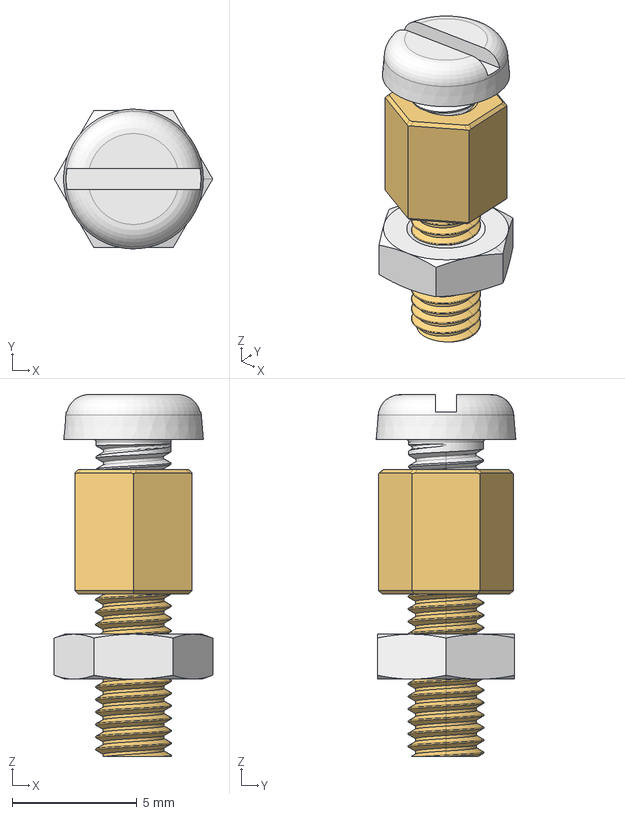
[picture p64: CAD file, 2020-08-18]
3d_models/Distance8mm-Hex5mm_plus_M3x5.step
6.35 x 5.60 x 14.5 mm
Hexdistance5mm_M3x6
ISO4035-M3_thin_nut
ISO1580-M3x5_screw
