mjohansson/customlib_mj/3d_models/TE_1734346-1-c-3d.stp

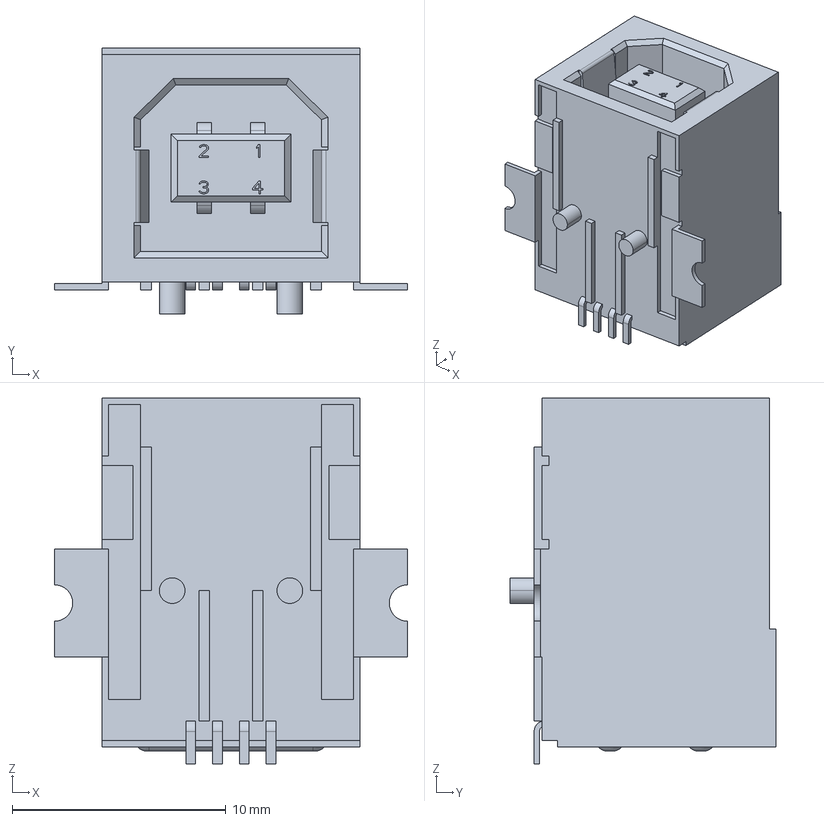
[picture p65: CAD file, 2020-08-18]
3d_models/TE_1734346-1-c-3d.stp
16.5 x 12.4 x 17.1 mm
