mjohansson/customlib_mj/3d_models/FFC_14p-WE_687114182122_rev1.stp

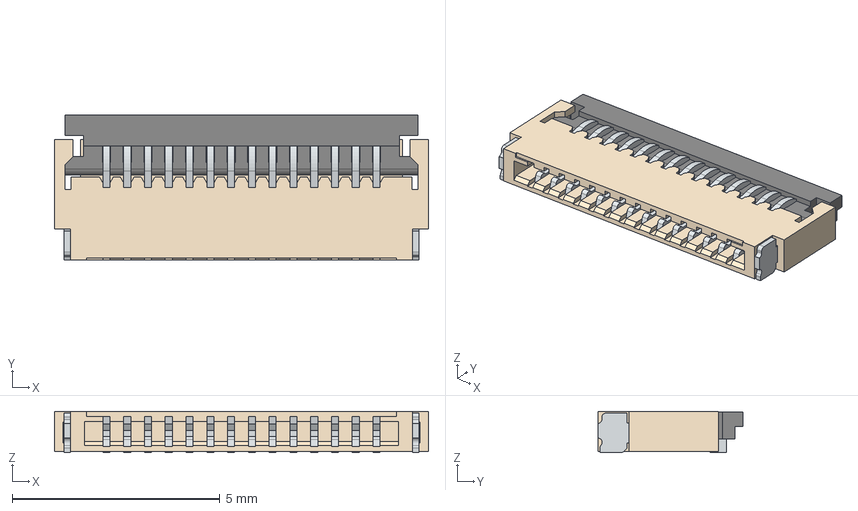
[picture p66: CAD file, 2020-08-18]
3d_models/FFC_14p-WE_687114182122_rev1.stp
9.00 x 3.50 x 0.988 mm
6871xx182122_Pad x 2
6871xx182122_Pin x 14
687114182122_Actuator
