mjohansson/customlib_mj/3d_models/TE_1-292303-1-e-3d.stp

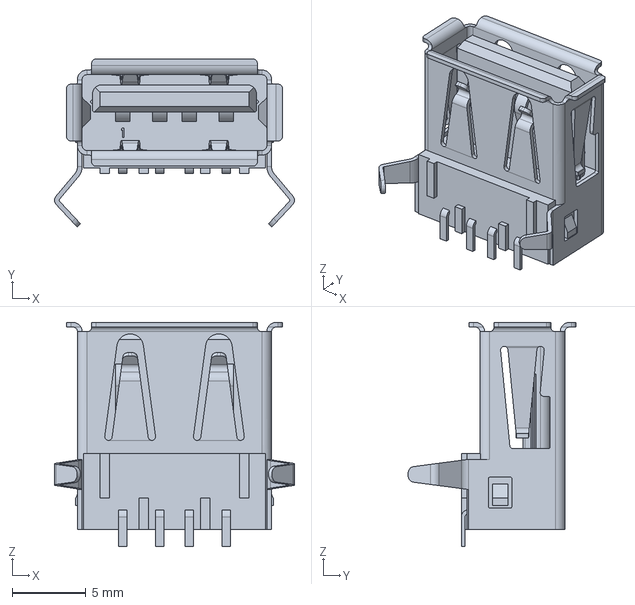
[picture p67: CAD file, 2020-08-18]
3d_models/TE_1-292303-1-e-3d.stp
16.2 x 11.4 x 15.2 mm
