mjohansson/customlib_mj/3d_models/MARS-Chassie-mounted_USB_01.stp

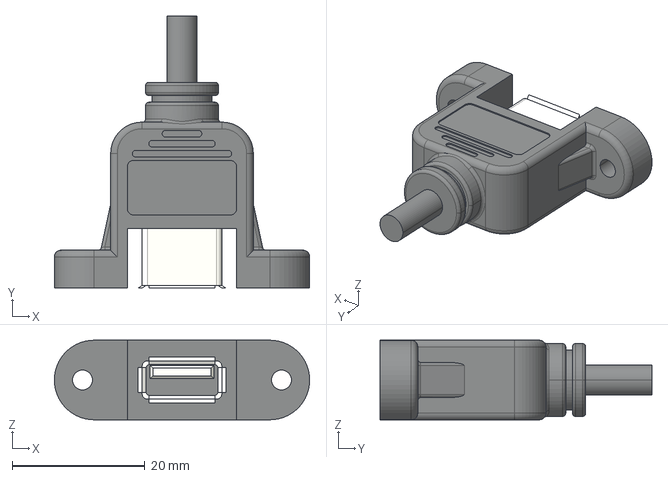
[picture p68: CAD file, 2020-08-18]
3d_models/MARS-Chassie-mounted_USB_01.stp
38.5 x 41.0 x 12.0 mm
