mjohansson/customlib_mj/3d_models/Meanwell_LRS-150.stp

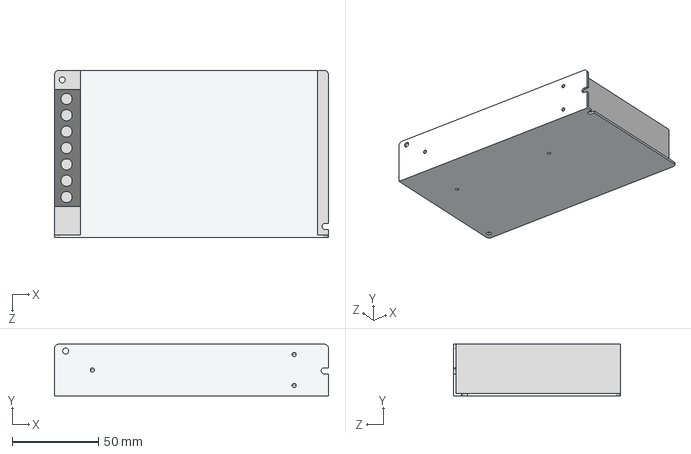
[picture p69: CAD file, 2020-08-18]
3d_models/Meanwell_LRS-150.stp
159.0 x 30.0 x 97.0 mm
