mjohansson/customlib_mj/3d_models/MARS-Chassie-mounted_Fuse_holder.stp

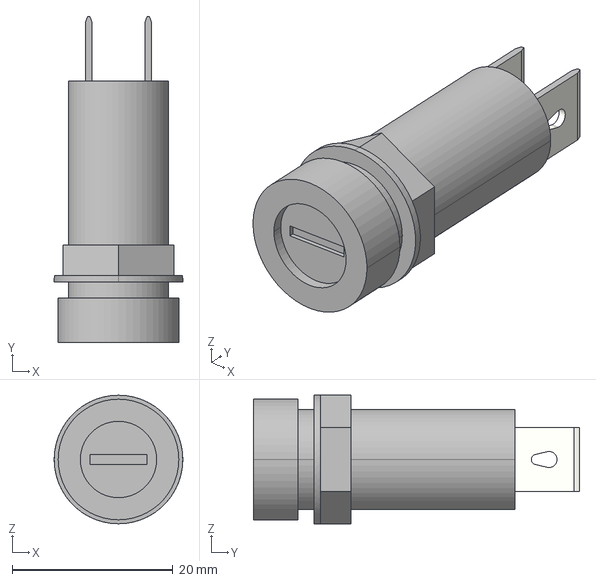
[picture p70: CAD file, 2020-08-18]
3d_models/MARS-Chassie-mounted_Fuse_holder.stp
16.0 x 40.5 x 16.0 mm
