mjohansson/customlib_mj/3d_models/NHD-3.12-25664UCxx.STEP

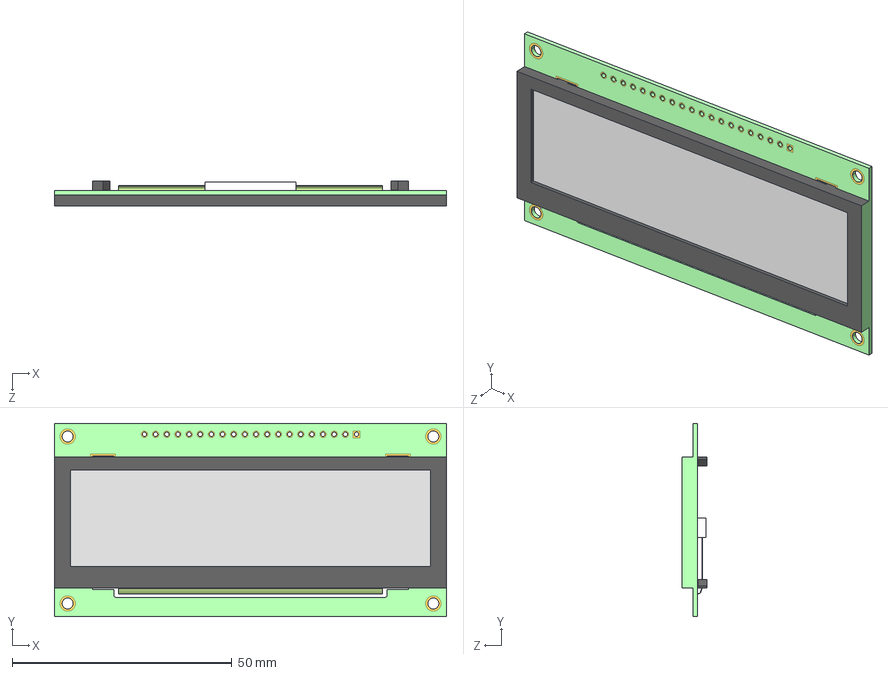
[picture p71: CAD file, 2020-08-18]
3d_models/NHD-3.12-25664UCxx.STEP
89.2 x 44.0 x 5.70 mm
