mjohansson/customlib_mj/3d_models/ASPI-0603LR.stp

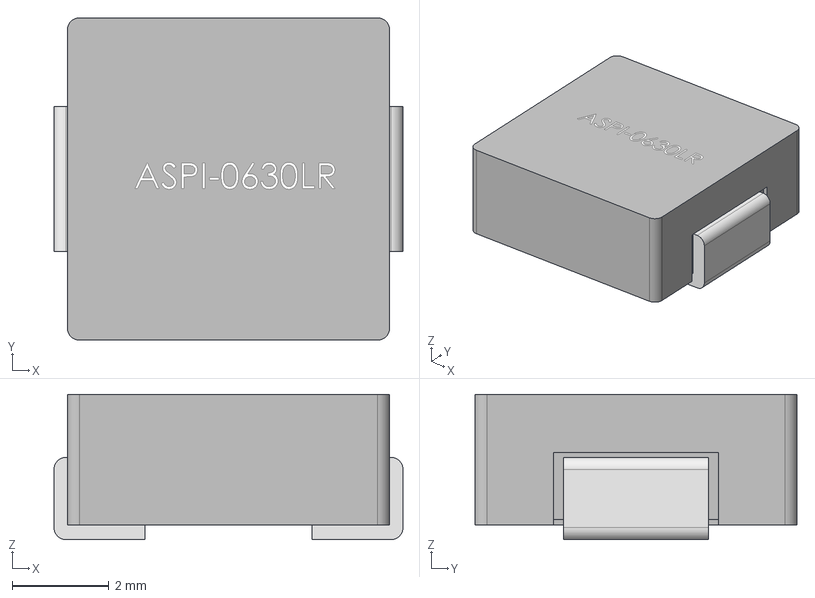
[picture p72: CAD file, 2020-05-09]
3d_models/ASPI-0603LR.stp
7.20 x 6.65 x 3.00 mm
