mjohansson/customlib_mj/3d_models/pushbutton_smd_6x6x4.3mm.step

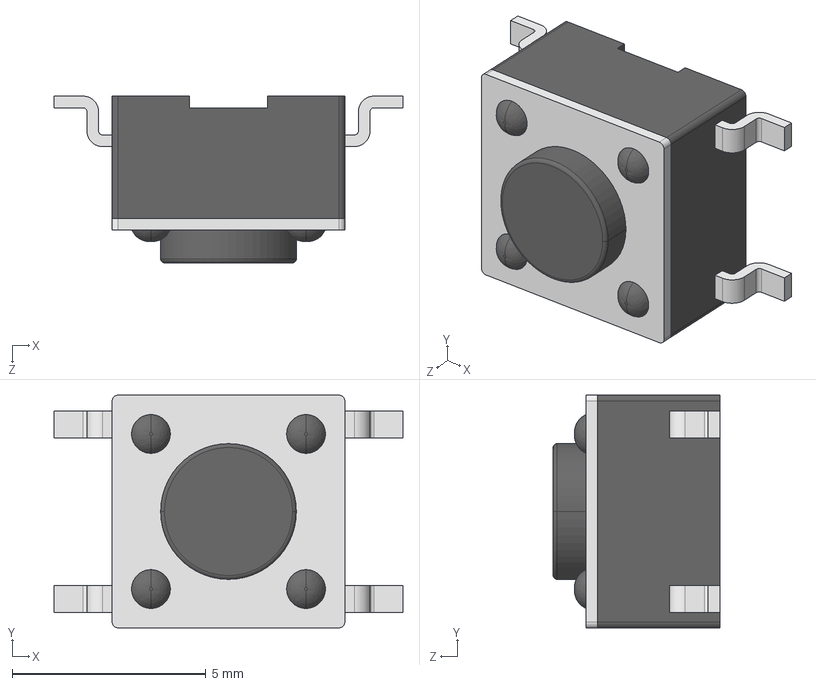
[picture p73: CAD file, 2020-05-05]
3d_models/pushbutton_smd_6x6x4.3mm.step
9.00 x 6.00 x 4.30 mm
