mjohansson/customlib_mj/(list of files, cad)

Other CAD files:
3d_models/3dholder_right_asm-1xM3.stp
3d_models/87-DC3-201.stp
3d_models/MARS-Chassie-mounted_USB.stp
3d_models/74980104400_WE-RJ45_LAN_rev1.stp
3d_models/909017-16020-3001 125t_16awb.stp
3d_models/FM_telescope_antenna_screwtype_45cm_pivot.stp
