mjohansson/customlib_mj/(commit log)

2020-05-05 Add files via upload
    Initial commit
    [74980104400_WE-RJ45_LAN_rev1.stp, ip101ga.csv, ip101ga.ods, pushbutton_smd_6x6x4.3mm.step, stm32f429v.csv, stm32f429v_full.csv, stm32f429v_lr_v2.csv, stm32f429v_part.csv]
2020-05-06 Added: * Epson TSX3235-xxx - crystals (16, 25MHz) * TLV905xS - op-amps with shutdown * REF6125 - 2.5V precision voltage reference * AD8552ARU - high precision op.amp
2020-05-09 Added stuff (mostly Pluto vmain-buck etc) : * 74LVC1G17DCK (single D Flipflop) * 74LVC74APW (dual D Flipflop) * 87DC3-201 (Grayhill Dual pushbuttons) * APXG160ARA101ME61G (100uF Polymer cap) * ASPI-0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
    Also a bunch of corrsponding footprints & 3d-models (incl. own from-scratch creation, the 87DC3-201 model :)
    [87DC3-201.fcstd, 87DC3-201.stp, ASPI-0603LR.stp]
2020-08-18 Lots of summer-vacation 2020 updates to the custom-lib!
    * Updated generator scripts for STM32F49V* - moved some pins in the POWER sub-part
    * Lots of new or modified parts
    * Lots of new 3d-models
    [3dholder_left_asm.stp, 3dholder_right_asm-1xM3.stp, 3dholder_right_asm.stp, 87-DC3-201.stp, 87-DC3-201_simple.stp, 87DC3-201.fcstd, 87DC3-201.stp, Amphenol_C707_10M006_052_2.stp]
2020-08-18 Add note of Vgs (+-20V) to Si4497DY PFET
2020-08-21 Created step model of FM Antenna (45cm, pivot, screw conn.)
    [FM_telescope_antenna_screwtype_45cm_pivot.stp]
2020-08-22 New 'hybrid' frontpanel left-side assembly; allowing either PwrBtn OR a 2nd rotary encoder
2020-08-22 * Added outer-panel cutouts for the 'hybrid' 2nd-rotary configuration * Slight updates to the 'hybrid' footprint for the inner display board
2020-08-22 Updated Frontpanel 'hybrid' left 2nd rotary holder footprint, to match new 3d-print holder geometry
2020-08-23 New user-defined 'dogbone's. Added solder-mask cutout also to old dogbones. Added SOT-416 & SOT-523 from BoB- resp. Blinkenlichten-libs
2020-08-24 Created component & 3d-model for cheap chinese DS3231 RTC module (also featuring a 24C32 i2c eeprom)
    [DS3231_Module_MJ-assembly.stp]
2020-08-24 6-pin variant of DS3231 module symbol (removed the pins for the optional 4-pin interface on the far short-side)
2020-08-24 Added 2nd-rotary 3dprinted assembly. Made old pwrbtn-footprint generic with the 2nd-rotary support signals
    [3dholder_left_asm.stp]
2020-08-24 Updated 3dholder-right asm steps to the 'r3' version (9.5mm height)
    [3dholder_right_asm.stp]
2020-08-24 Aligned Grayhill pocket cutouts in both left- & right assemblies footprints for Display-board. Outer panel cutouts unchanged!
2020-08-24 mech: updated step of 3dholder_left assembly
    [3dholder_left_asm.stp]
2020-08-24 Added step7wrl of 28mm Al 'volume'-knob (Mentor, pn: 5555-6612)
    [AlKnob28mm-Mentor_5555_6612.stp]
2020-08-26 Created symbols & 'footprints' (panel cut-outs) for: Schaffner FN283 AC-inlet, Schurter fuse-holder and Amphenol T3437000 DIN7
2020-08-30 Added cutout-footprint for outer panel, alternate left-side (feat. a 2nd rotary encoder)
2020-08-31 Added panel-cutout footprints for WE RJ45, TE USB-A and TE-USB-B connectors
2020-08-31 Added placeholder components & panel cut-out footprints for 3.5mm CUI connector & Kycon DSub-9
2020-09-03 3d-model for Kycon K22X (dsub-9 conn.)
    [K22X-E9P-N.step]
2020-09-03 Component representing MB cut-out for Schaffner FN283. (Not used; drew the cutout directly in the MB edge definition instead)
2020-09-05 3d models of CUI speakers; CES-30207 and CES-703116 (two variants; one basic and oneassembly with 5mm spacers and fasteners)
    [CUI_CES-30207-158L120-67.step, CUI_DEVICES_CES-703116-28PM.step, CUI_DEVICES_CES-703116-28PM_fasteners_assembly.step]
2020-09-05 Created footprints for CUI internal speakers; CES-30207 and CES-703116 (latter with PCB cut-out for through-board mounting)
2020-09-05 CES-703116 fasteners assembly updated with washers & countersunk screws. This results in a no-margin, tightest fit imaginable. No problem...
2020-10-06 Renamed retention pins in TE USB parts. Added new USB-A conn (CUI UJ2-AH-1-SMT) & panel cutout for same
    [CUI_DEVICES_UJ2-AH-1-SMT.step]
2020-10-06 New component: 4mm banana socket Stäubli LB-I4R-A, for backpanel earth connetion"
    [LB_I4R_A-black.stp, LB_I4R_A-red.stp]
2020-10-07 New component : Molex Nano-Fit 1x02; header & receptacle
    [Molex_NanoFit-1x02_receptacle-1053071202.stp, Molex_NanoFit_1x02-1054301202.stp]
2020-10-07 New component : SMA bulkhead jack/cable assembly; SMA right-angled PCB PTH; updated symbols lib
    [SMA_Molex_73251-2200_Horizontal.stp, SMA_bulkhead_jack_and_cable_assy.stp]
2020-10-20 Add 3d-model for Molex MicroFit 430-450412 (broken 3dmodel in the existing kicad comp.). This is the internal DC-in conn. for mainboard
    [Molex_MicroFit_430450421.stp]
2020-10-24 *) Add some missing 3d-models *) custom copy some conns- & SOIC-8 footprints to fix broken 3d-models
    [JST-BM02(4.0)B-PBVSS-TF.STEP, JST-SM02(4.0)B-PBVSS-TB.STEP, JST_B2B-PH-SM4-TB.STEP, JST_S2B-PH-SM4-TB.STEP, Molex_MicroClasp_559350210.stp]
2020-10-30 New PCB fuseholder (5x20mm Schurter OGN 0031.8201); cut-out for IDC 2x5 right-angled conn.
    [Schurter_0031_8201.step]
2020-11-03 * New components : some of Wurth WR-FAST series 6.3mm quick-connect cable-shoe blade connectors
    [Molex_PicoBlade_4p_Cable_assy-151340402.stp, Molex_PicoBlade_4p_Cable_assy-151340403.stp, WR-FAST_2ra_638263122002_rev1.stp, WR-FAST_2v_638263222002_rev1.stp, WR-FAST_3ra_638263122003_rev1.stp, WR-FAST_3v_638263222003_rev1.stp, WR-FAST_4ra_638263122004_rev1.stp, WR-FAST_4v_638263222004_rev1.stp]
2020-11-09 * Some new 3d-models; footprints SC74-6, hs-variant of SOT-523; added TS5a3159 analog mux, CM1213A-02SO 2ch ESD; minor fix-ups
    [Molex_PicoBlade_4p_v_smd-533980471.stp, SC74-6_SOT-457.stp]
2020-11-22 Components: CR2032 coin cell holder, CR2032 battery, combined footprint for DS3231M (SO16W) and DS3231MZ (SO8N)
    [BATT_CR2032.step, CoinCellHolder_CR2032.step]
2020-12-21 New sch comp: B5819W - 40V, 1A Schottky diode from LCSC Basic range (p/n C8598)
2020-12-29 Add Alpha&Omega AO4407A P-FET (LCSC basic part)
2020-12-30 Add some 3d-models (e.g. KYCON KLD, STX-3501 3.5mm dbgconn etc)
    [LED_RGB_3528RGB4C-CA.stp, LED_RGB_SERIE_SK6812MINI.stp]
2020-12-30 Add symbol(placeholder) & footprint for JLCPCB assembly tooling-holes
2020-12-31 Arturo182's JLCPCB BoM modifier script (slightly modded, to set label 'LCSC Part Number' instead of just 'LCSC')
2020-12-31 Added silk- and soldermask graphics for rear-panel labels & icons
2021-01-03 Display-flush without breakaway tabs. Added signals to screw-pads on left- & right buttonholders
2021-01-09 Add misc. missing 3d-models
    [DIN7_done.stp, EC11E-15SW.STEP, Green_0603_sidelooking_LED.step, HTSSOP-56-1EP_6.1x14mm_P0.5mm_EP3.61x6.35mm.step, Litttlefuse 1206.step, Oscillator_70x50mm_4p-matches_O705030MGDA4SC.step, Piezo-CUI_CSQ_601BP-Compatible_with_ZL-YDW12055.step, Piezo_CUI_CMT-13031-SMT-compatible_with_KLJ-1325.step]
2021-01-10 Customlib rel-paths (3d-models relative to KICUSTOMLIB_DIR/)
    [3dholder_left_asm.stp, 3dholder_right_asm.stp, 87-DC3-201.stp, 87-DC3-201_simple.stp, Amphenol_C707_10M006_052_2.stp, BATT_CR2032.step, CUI_CES-30207-158L120-67.step, CoinCellHolder_CR2032.step]
2022-01-12 4-pin (PWM) chassis fan pin-header
2022-01-15 kicad 6: split out a v6-version of customlib_mj
    (v5 dir kept as-is for now. Maybe create a v5 branch instead?)
2022-01-21 adjusted cutouts for : USB_A, RJ45, Amphenol DIN, front-panel pwr-button
2022-02-02 New and updated 3d-placeholders for e.g. frontpanel, rear-panel etc, to be used in PCB 3d-view
    [3d_assm_bottomplate_w_feet.step, 4mmBanana_panel_with_QC.step]
2022-04-07 Saved a customized Molex_MicroFit_30-43045-0421 from solderstn_mb, where is was previously a locally modified generic 2x2 connector sym
2024-02-26 Add 3d-models for 16-pin 'picoblade' & LCSC uUSB-conn
    [909017-16020-3001 125t_16awb.stp, Jing-Extension-of-the-Electronic-Co--920-E52A2021S10100_C10418.stp]
2024-02-26 kiparts: Nuvoton M487
    [Nuvoton_M487KIDAE_sheets.ods]
2024-02-26 add fp:s for uUSB, Picoblade 1x16, RJ45 and FFC_14p 0.5mm etc
2024-02-26 16-pin 'picoblade' converted from FF Altium lib
