mjohansson/customlib_mj/(notices)

Notices in the files:
3d_models/SOIC-16_3.9x9.9mm_P1.27mm.step:
Copyright (C) 2017, kicad StepUp
This work is licensed under the [Creative Commons CC-BY-SA 4.0 License](https://creativecommons.org/licenses/by-sa/4.0/legalcode),
with the following exception:
To the extent that the creation of electronic designs that use 'Licensed Material' can be considered to be 'Adapted Material',
You are free to use the library data in your own projects without the obligation to share your project files under this or any other license agreement.
3d_models/Molex_MicroFit_430450421.stp:
FILE_NAME( 'C:/Users/KMIROS~1/AppData/Local/Temp/psolqas_22492_42.stp', '2020-07-09T08:02:15', ( 'License CC BY-ND 4.0' ), ( 'CADENAS' ), ' ', 'PARTsolutions', ' ' );
